ETML-ES-SLO/PRJ_1819_EmetteurDCF/1819A/doc/Présentations/PROJ_DESIGN.pptx

## Emmetteur DCF Partie Design

Julie Culand
Etml-es
Sl02
2018-2019

## Table des matières

- Description du produit (schéma bloc)
- Détail du schéma bloc
=> Choix technologiques
=> Dimensionnement
- Conclusion

## Description du produit voulu

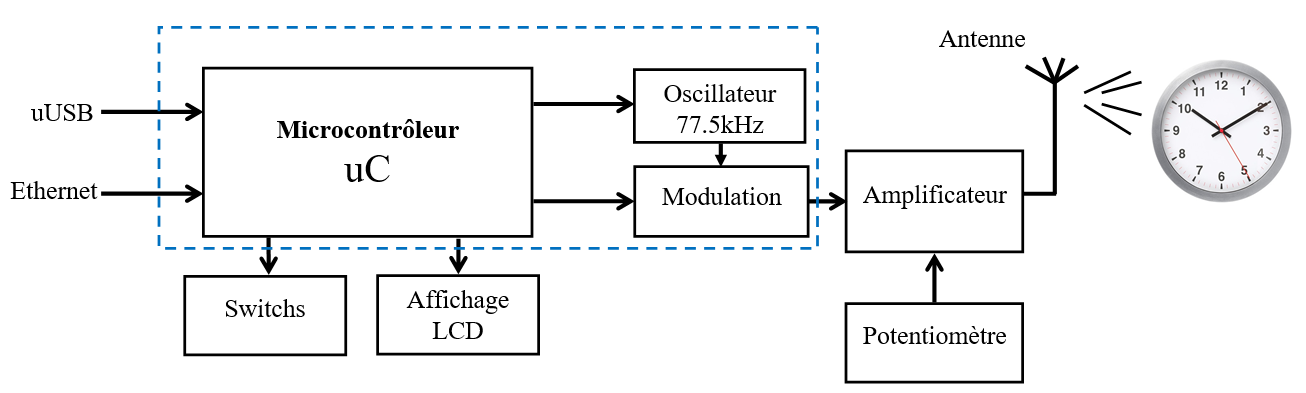
[picture p1: figure]

## Détail du schéma bloc

- Alimentation uUSB
- Touches menu
- Régulateur 5V à 3V3
- Affichage LCD
- Signaux DCF
- RESET du uC & Connecteur de programmation
- Contrôleur Ethernet

## Alimentation uUSB

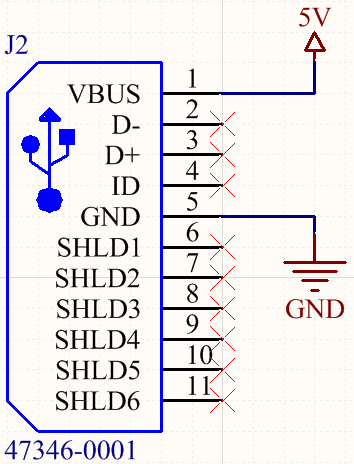
[picture p2: figure]

## Touches menu

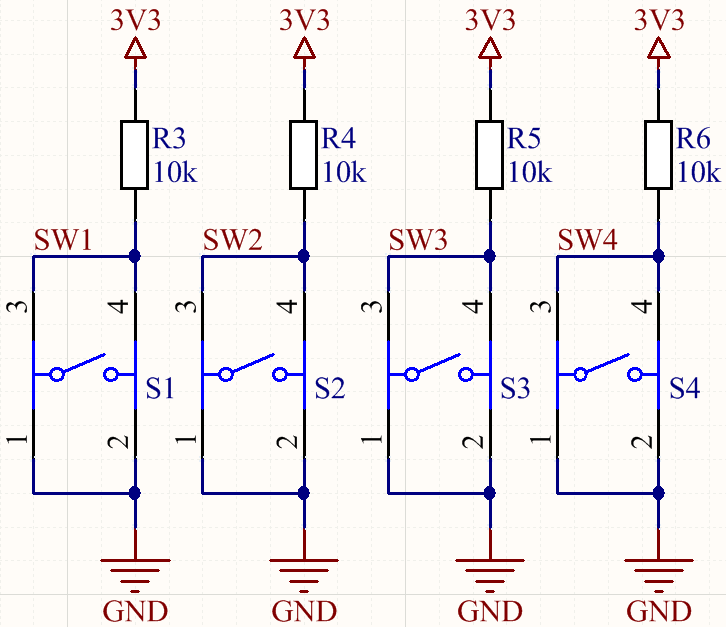
[picture p3: figure]

## Régulateur 5V à 3V3

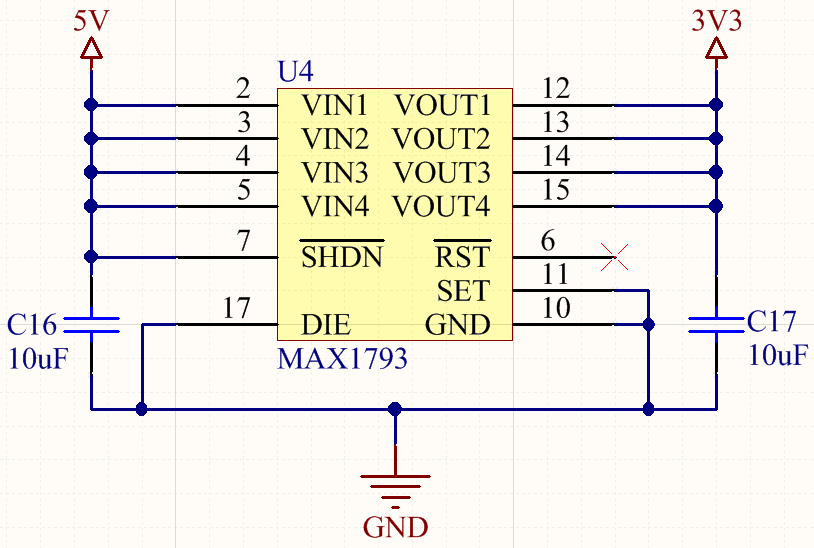
[picture p4: figure]

## Affichage LCD & uC

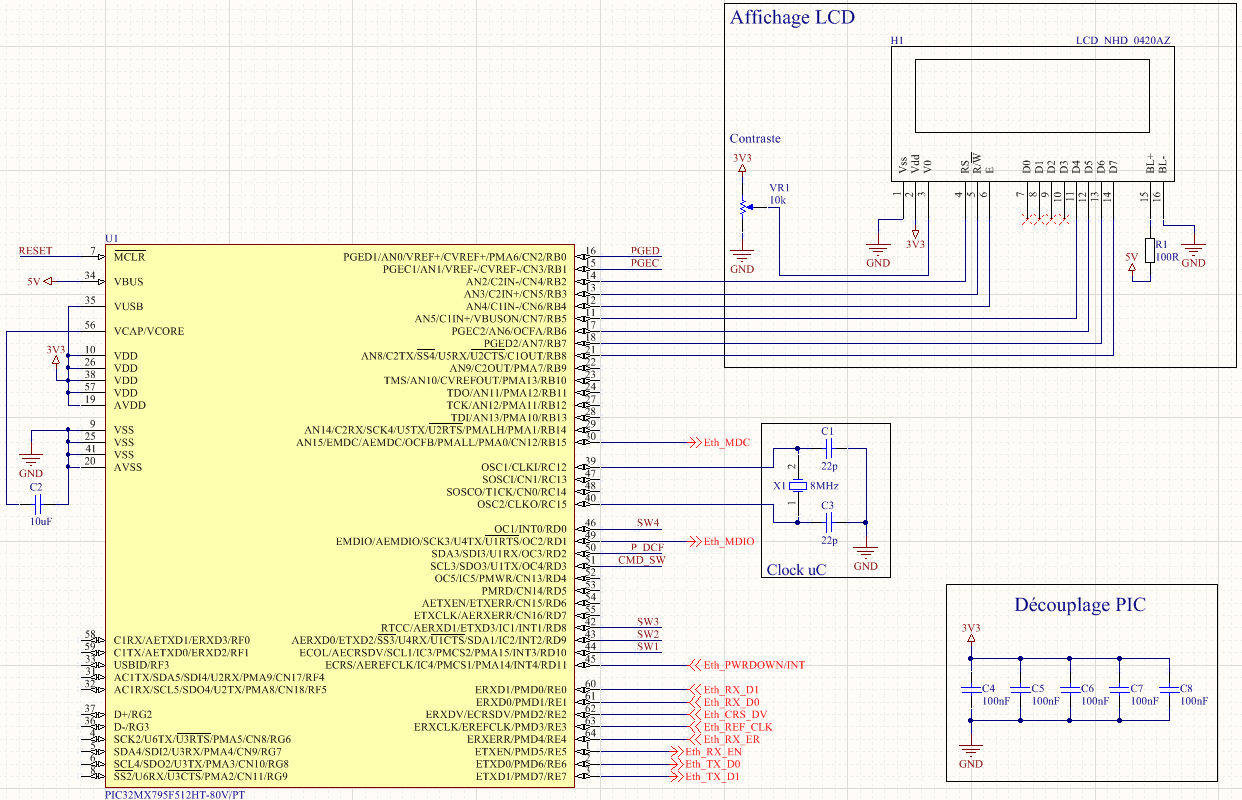
[picture p5: figure]

## Signaux DCF

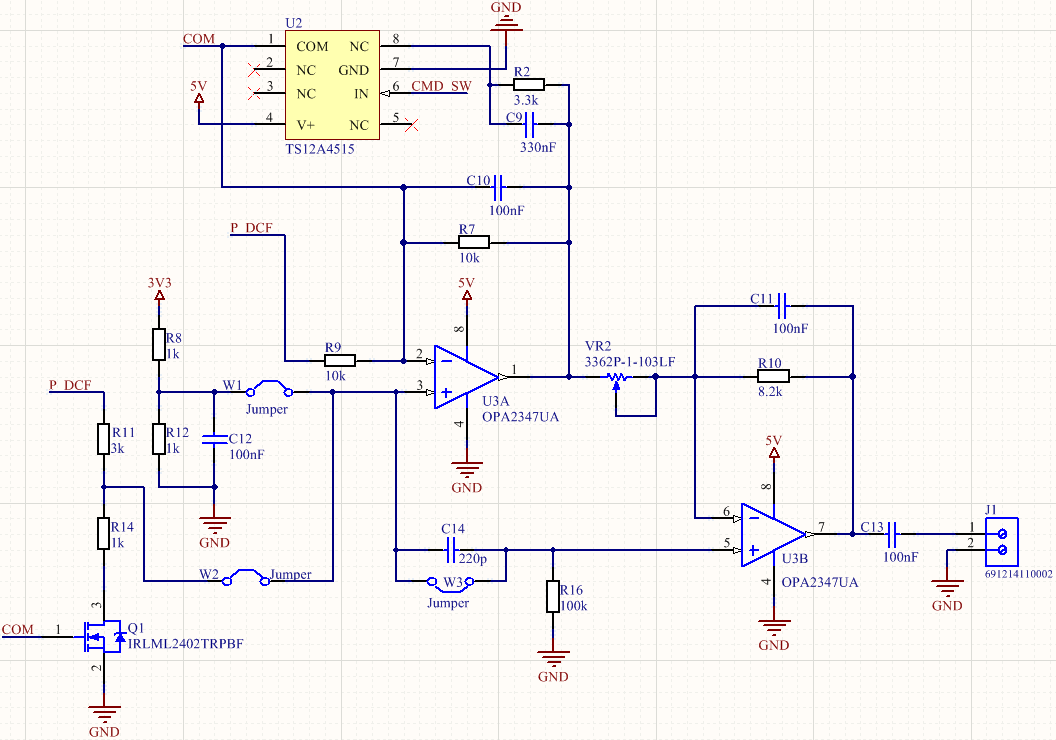
[picture p6: figure]

## Simulation

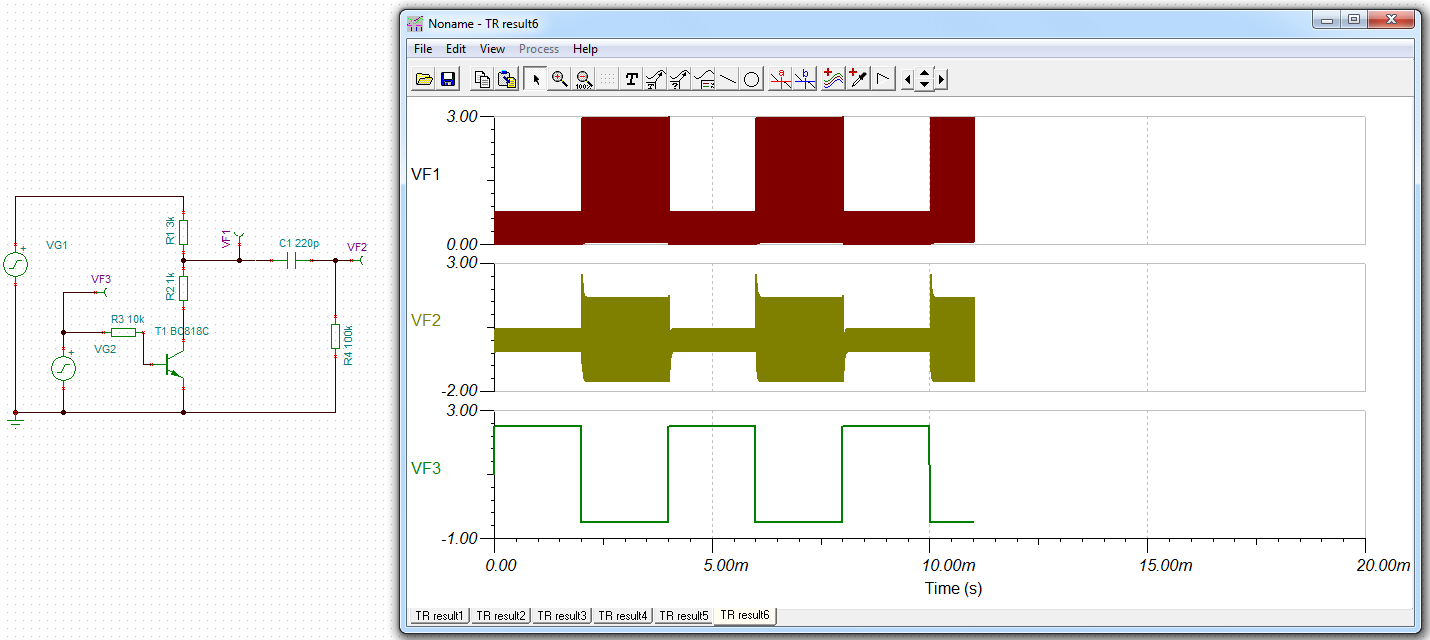
[picture p7: figure]

## RESET du uC & Connecteur de programmation

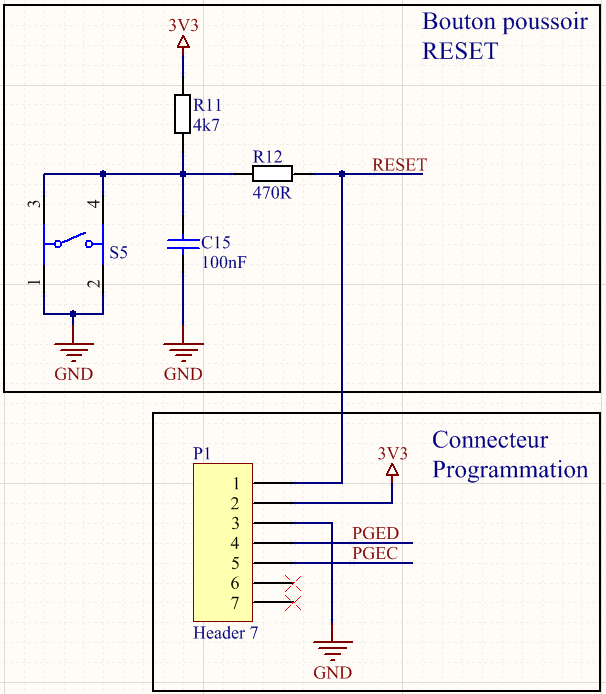
[picture p8: figure]

## Contrôleur Ethernet

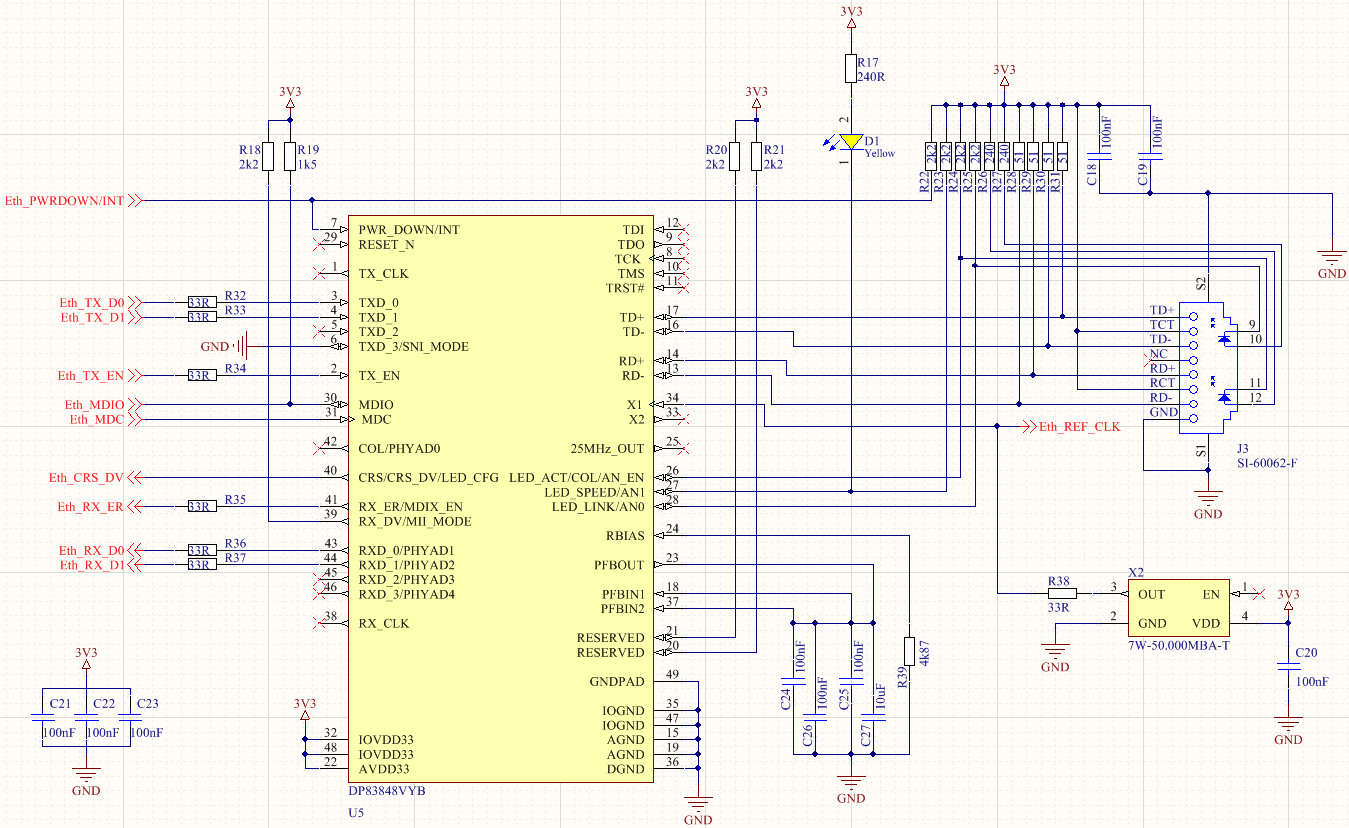
[picture p9: figure]

## Conclusion

- Réalisation Schéma électrique
- Choix technologies + taille de boîtiers
- Travailler dans un esprit "d'entreprise"
- Partie DCF
- Réalisation du PCB

## QUESTIONS ?

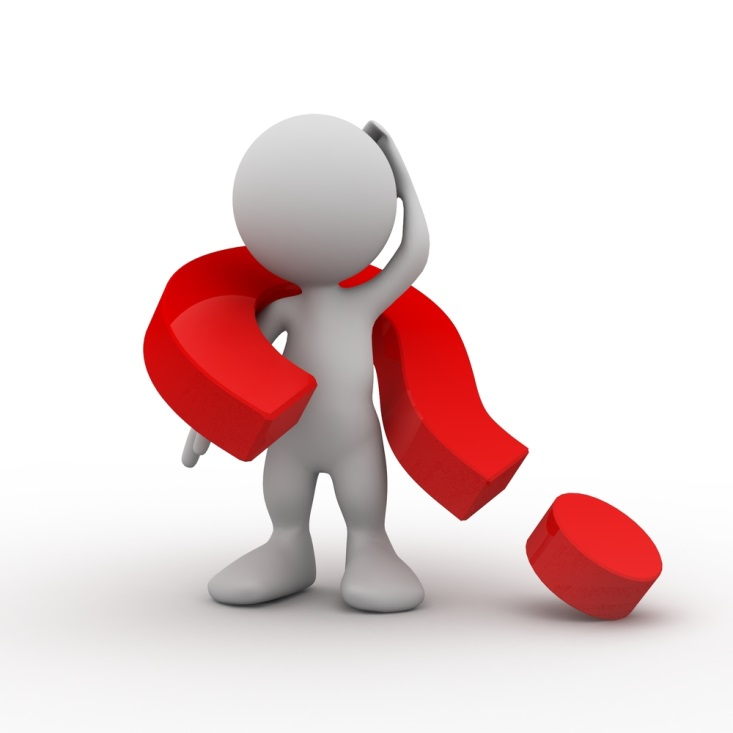
[picture p10: figure]
