ETML-ES-SLO/PRJ_1819_EmetteurDCF/1819A/doc/ANNEXES/Annexe_VIII_Normes_Euro_circuit.pdf

Normes Euro-circuit

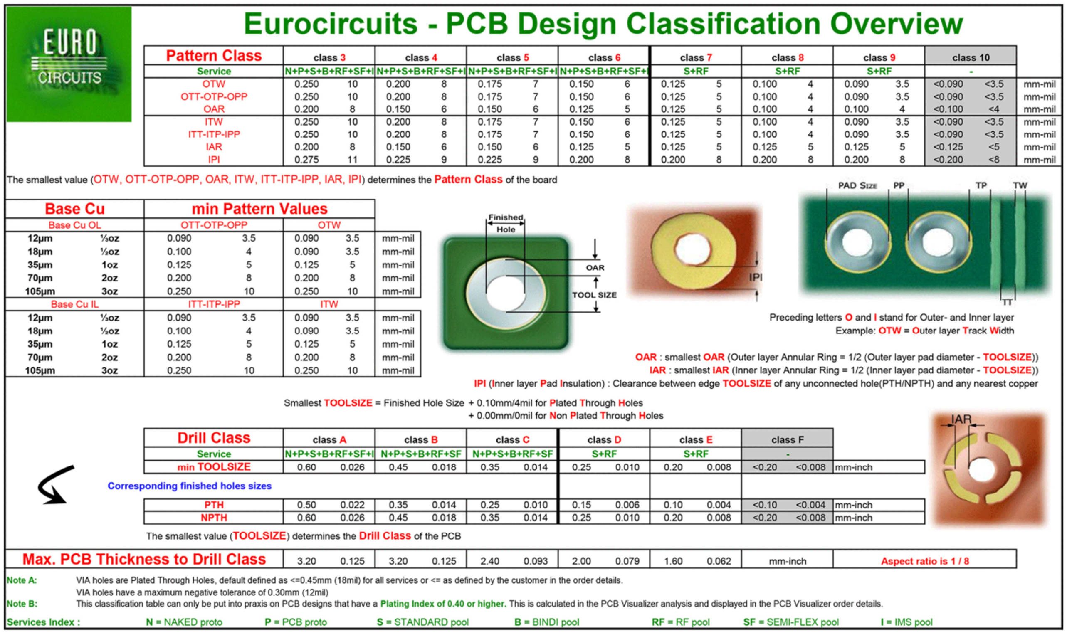
[picture p11: figure]

Normes : 6C
