ETML-ES-SLO/PRJ_1819_EmetteurDCF/1819A/doc/Doc DCF/Homebrew DCF-77 Transmitter.pdf

Homebrew DCF-77 Transmitter | https://www.changpuak.ch/electronics/DCF77.php

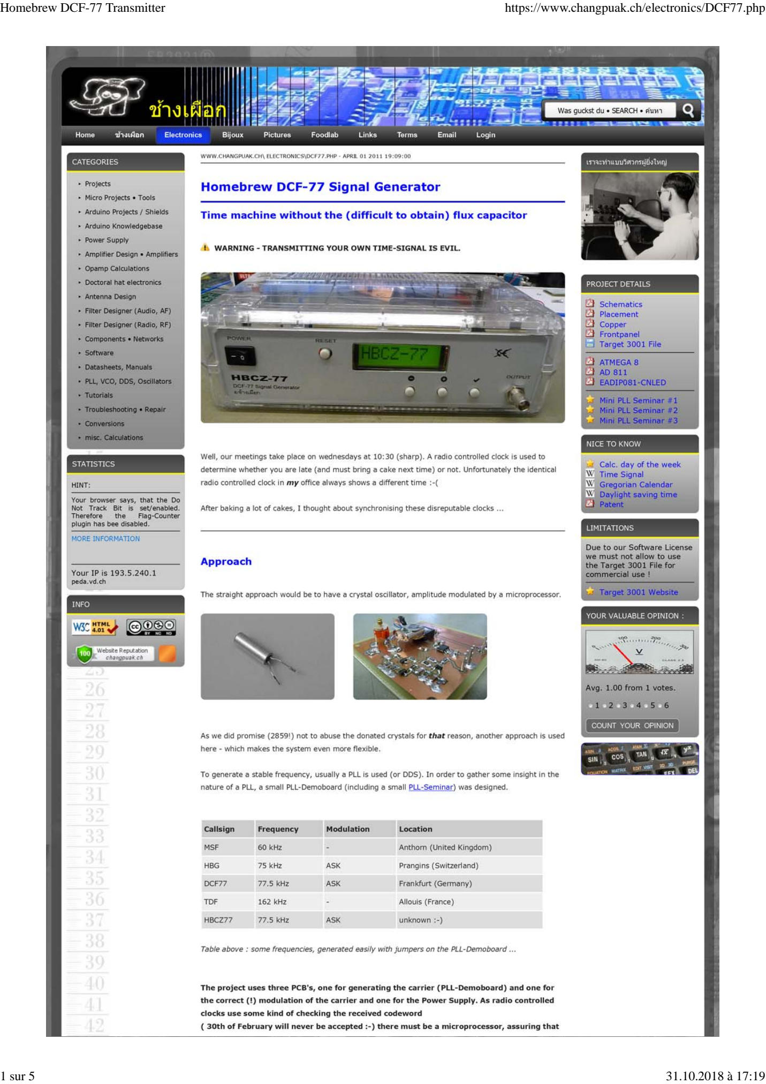
[picture p18: page 1]

1 sur 5 | 31.10.2018 à 17:19

the sent generated codeword is valid.

- PCB#1 may be any clock source of the carrier of your choice. We use the PLL-Demoboard.
- PCB#2 is the Frontpanel, containing the Microprocessor and ASK Modulator. (Picture below)
- PCB#3 is some kind of Power Supply, delivering +12V...+30V/200 mA and + 5V/100 mA.

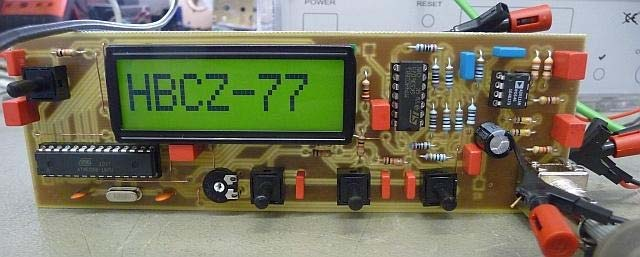
[picture p19: figure]

Picture above : The Mainboard, assembled, behind the Frontpanel.

## Modulation

The Amplitude Modulation is done with 4 AND-Gates and a R-2R Network. It is therefore possible to modulate the TTL Signal with 16 Steps.

This is somehow cracking a nut with a sledgehammer, but we wanted to present something nifty to comply with the 'educational aspect'.

Note: As we wanted to have a single sided PCB, we reduced this later to 3 Bit.

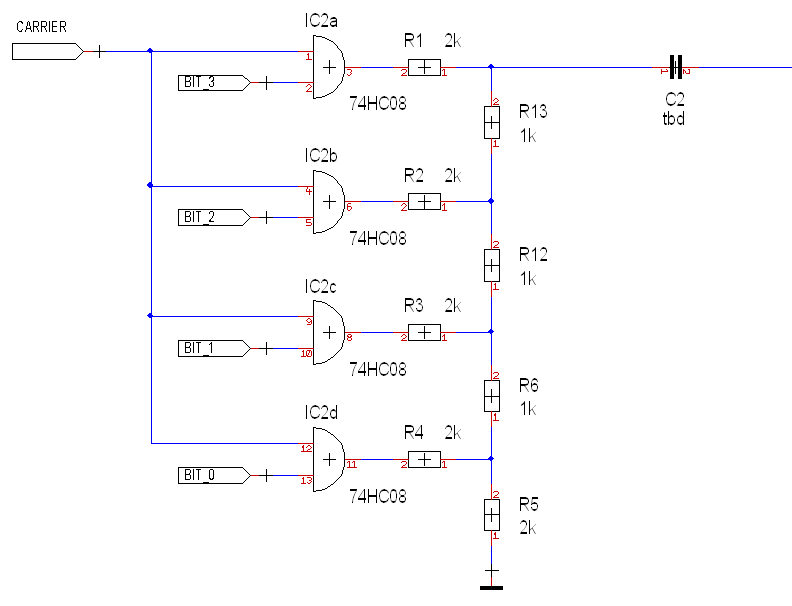
[picture p20: figure]

## ... and what you see on a Scope

Where a '0' is represented by a 100 ms drop to 25% Amplitude and a '1' drop lasts 200 ms.

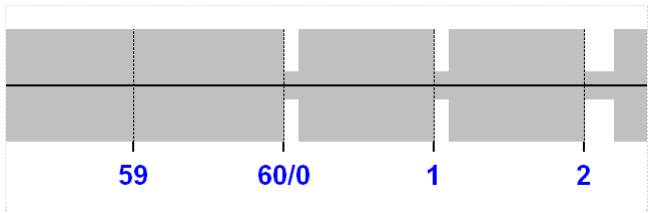
[picture p21: figure]

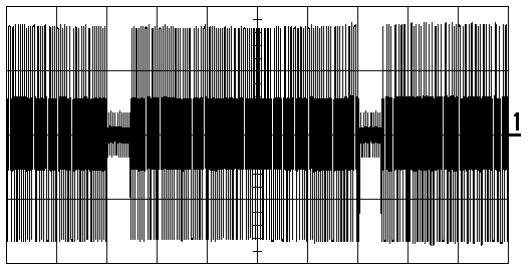
[picture p22: figure]

Picture above : Horizontal: 200 ms/DIV, Vertical: 1 V/DIV

## DCF77 Time Code (similiar to HBCZ77 Time Code :-)

Bit/Sec. | Meaning | Remarks
0 | Start of a Minute | always = 0
1-14 | reserved / for future use
15 | 0=Normal Antenna, 1=Backup Antenna
16 | Summer Time Announcement | Set 1 hour before
17 | Summer Time 0=No, 1=Yes
18 | Winter Time 0=No, 1=Yes
19 | Leap Second announcement | Set 1 hour before
20 | Startbit encoded Time | always = 1
21 | Minutes, weight = 1
22 | Minutes, weight = 2
23 | Minutes, weight = 4
24 | Minutes, weight = 8
25 | Minutes, weight = 10
26 | Minutes, weight = 20
27 | Minutes, weight = 40
28 | Parity Bit Minutes (even) | Bits 21 - 28
29 | Hours, weight = 1
30 | Hours, weight = 2
31 | Hours, weight = 4
32 | Hours, weight = 8
33 | Hours, weight = 10
34 | Hours, weight = 20
35 | Parity Bit Hours (even) | Bits 29 - 34
36 | Day of the Month, weight = 1
37 | Day of the Month, weight = 2
38 | Day of the Month, weight = 4
39 | Day of the Month, weight = 8
40 | Day of the Month, weight = 10
41 | Day of the Month, weight = 20
42 | Day of the Week, weight = 1 | Monday = 1
43 | Day of the Week, weight = 2 | Tuesday = 2
44 | Day of the Week, weight = 4 | Wednesday = 3
45 | Number of the Month, weight = 1
46 | Number of the Month, weight = 2
47 | Number of the Month, weight = 4
48 | Number of the Month, weight = 8
49 | Number of the Month, weight = 10

50 | Year, weight = 1 | ( 00 - 99 )
51 | Year, weight = 2
52 | Year, weight = 4
53 | Year, weight = 8
54 | Year, weight = 10
55 | Year, weight = 20
56 | Year, weight = 40
57 | Year, weight = 80
58 | Parity Bit Date (even) | Bits 36 - 57
59 | Minute Sync | Carrier unmodulated

Putting it all together ...

A radio controlled clock is modified therefore, that the generated Signal is fed directly into the Amplifier following the Antenna. (Decoupling with an 1 kΩ Resistor).

It is assumed, that the portion radiated through the Antenna is very small, as we use an
Attenuator of 30 dB. (and of course operate it in a fully shielded room :-)

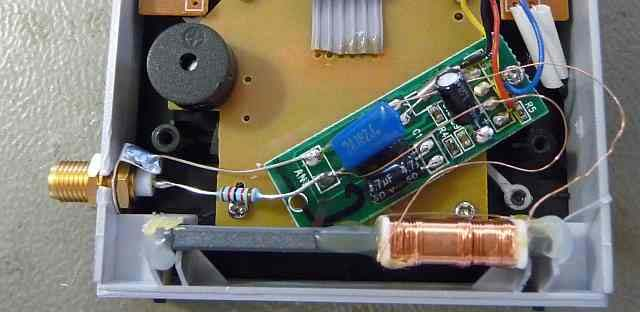
[picture p23: figure]

Connecting the Signal Generator to the Clock - using a DC-Block and a 30 dB Attenuator from Mini Circuits - the Situation is as follows :

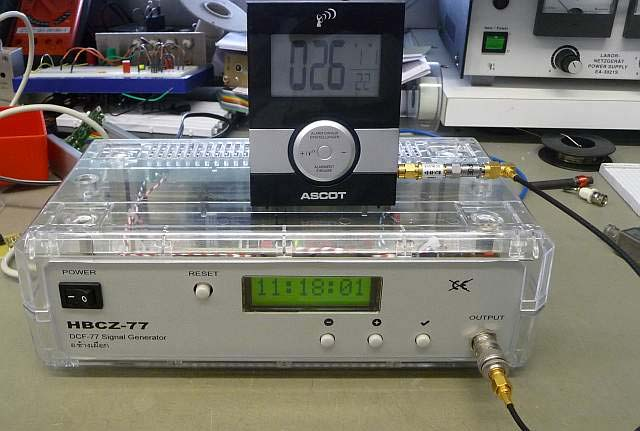
[picture p24: figure]

## ✈ Share your thoughts

✈ Nothing more to be seen below this point ? Maybe your browser blocks the facebook iframe.
✈ The webmaster does not read the comments regularly. Urgent questions should be send via email.

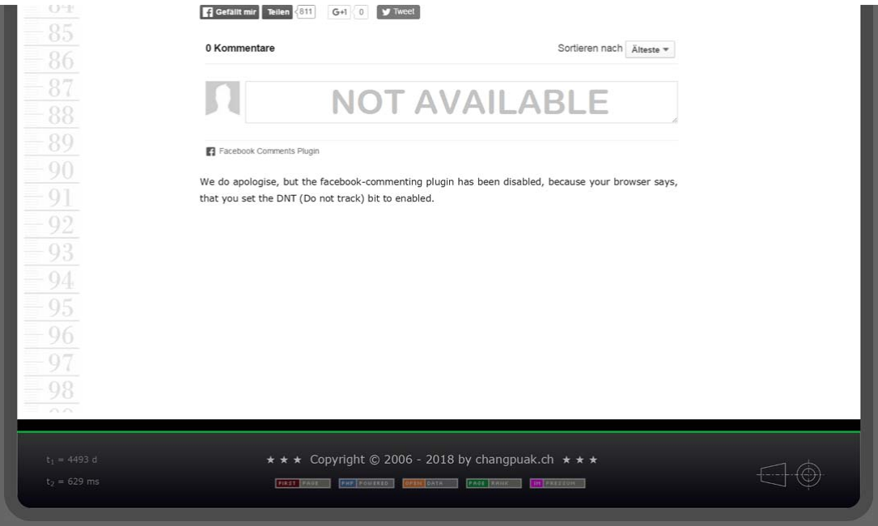
[picture p25: figure]
