ETML-ES-SLO/PRJ_1819_EmetteurDCF/1819A/doc/ANNEXES/Annexe_IV_PLANNING.pdf

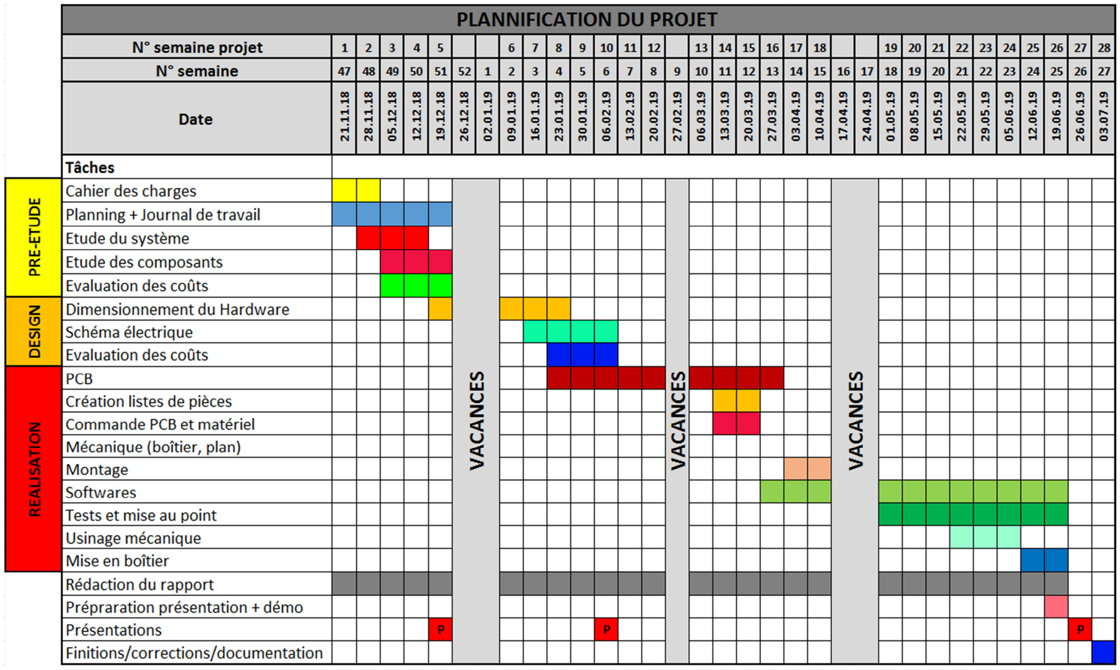
[picture p28: page 1]
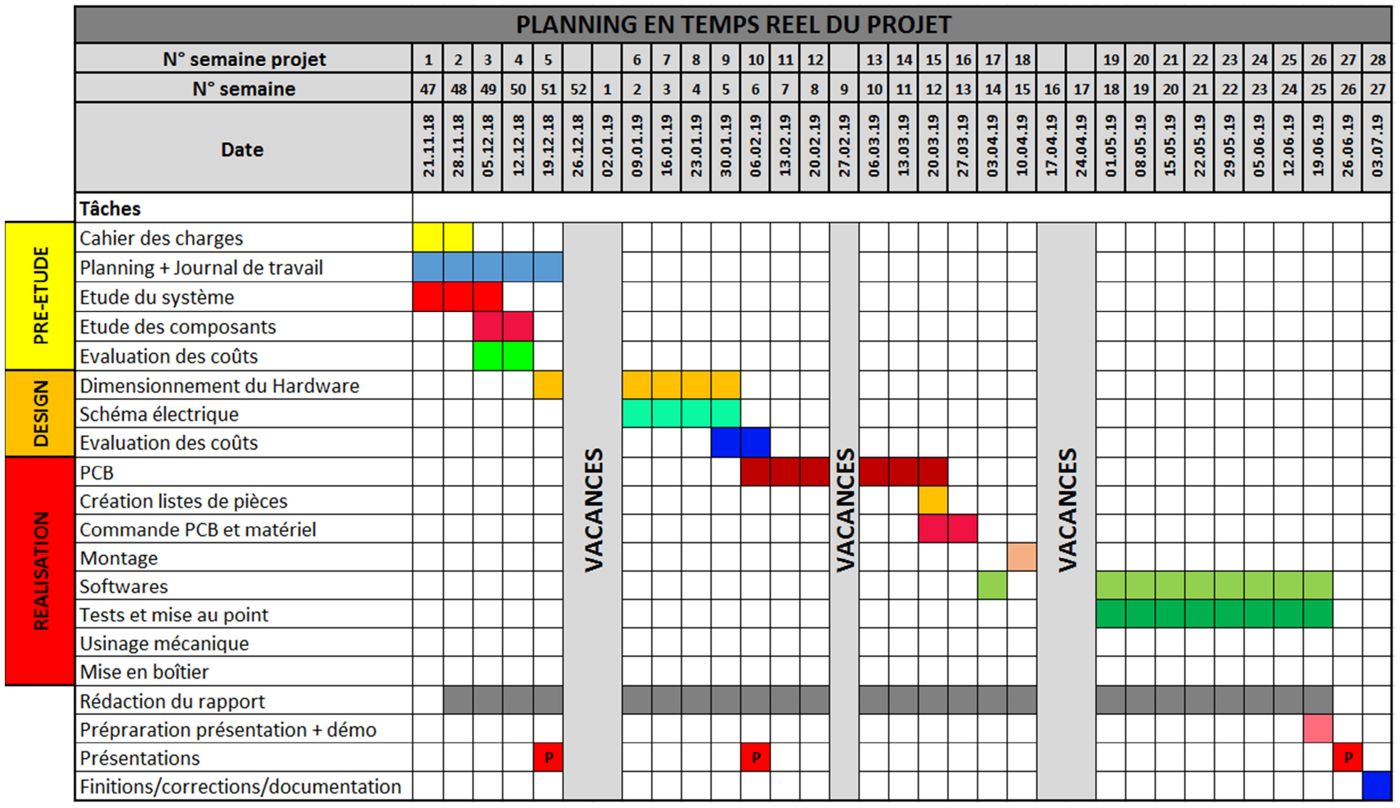
[picture p29: page 2]
