ETML-ES-SLO/PRJ_1819_EmetteurDCF/1819A/doc/IMAGES/Clock_Diagram.png

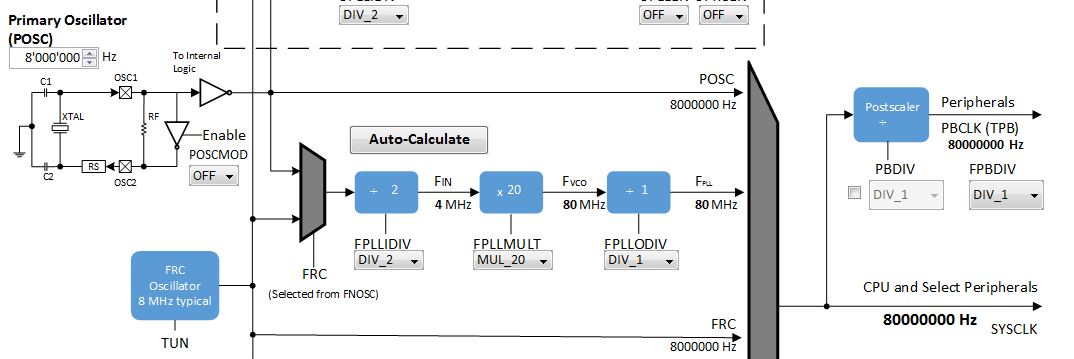
1819A/doc/IMAGES/Clock_Diagram.png
