ETML-ES-SLO/PRJ_1819_EmetteurDCF/1819A/doc/IMAGES/PIN_DIAGRAM.png

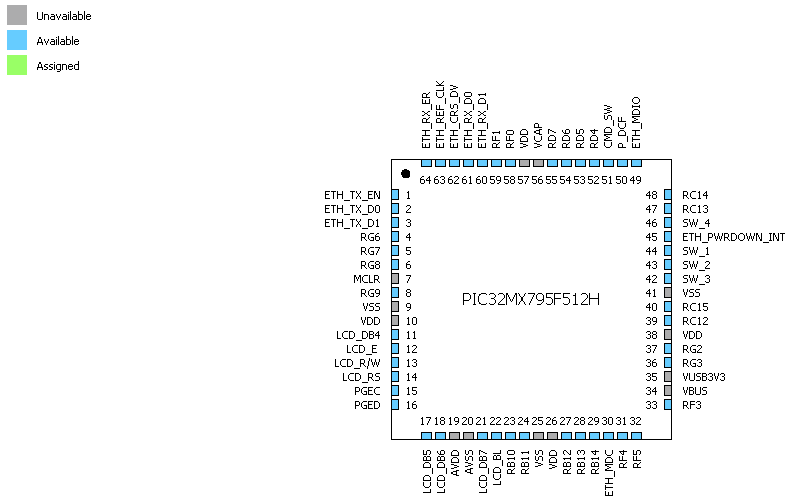
1819A/doc/IMAGES/PIN_DIAGRAM.png
