ETML-ES-SLO/PRJ_1819_EmetteurDCF/1819A/doc/IMAGES/Pin_Settings_1.png

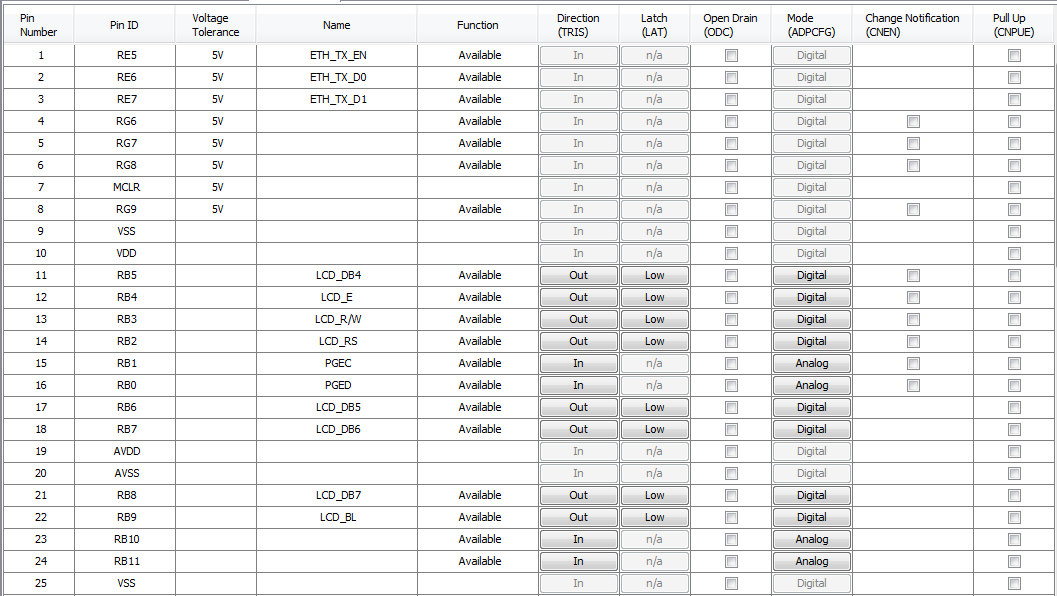
1819A/doc/IMAGES/Pin_Settings_1.png
