ETML-ES-SLO/PRJ_1819_EmetteurDCF/1819A/doc/Plan_Montage.xlsx

PLAN DE MONTAGE
Quantity | Comment | Description | Boîtier | Designator | SMD / THT | Ordre montage
19 | 100nF | Capacitor | 0805 | C1, C2, C3, C4, C5, C9, C11, C12, C13, C14, C18, C19, C20, C21, C22, C23, C24, C25, C26 |  | 3
2 | 22pF | Capacitor | 0805 | C6, C8 |  | 3 | SMD
4 | 10uF | Capacitor | 0805 | C7, C16, C17, C27 |  | 3 | THT
1 | 330nF | Capacitor | 0805 | C10 |  | 3
1 | 220pF | Capacitor | 0805 | C15 |  | 3
1 | Yellow | SMT Chip LED | 0805 | D1 |  | 5
1 | LCD_NHD_0420AZ | Affichage LCD | ------------- | H1 |  | 23
1 | 691214110002S | Bornier 2 pôles | ------------- | J1 |  | 21
1 | 47346-0001 | Micro-USB B | ------------- | J2 |  | 13
1 | SI-60062-F | RJ45 Connector | ------------- | J3 |  | 22
1 | Header 7 | Header, 7-Pin | ------------- | P1 |  | 20
2 | BC857B | PNP Transistor | SOT23 | Q1, Q2 |  | 6
2 | IRLML2402TRPBF | MOSFET, N-Channel | SOT23-3 | Q3, Q4 |  | 7
1 | 39R | Resistor | 0805 | R1 |  | 4
7 | 10k | Resistor | 0805 | R2, R3, R4, R5, R12, R14, R16 |  | 4
1 | 1k8 | Resistor | 0805 | R6 |  | 4
1 | 200R | Resistor | 0805 | R7 |  | 4
2 | 100k | Resistor | 0805 | R8, R20 |  | 4
1 | 4k7 | Resistor | 0805 | R9 |  | 4
1 | 470R | Resistor | 0805 | R10 |  | 4
1 | 3.3k | Resistor | 0805 | R11 |  | 4
3 | 1k | Resistor | 0805 | R13, R18, R19 |  | 4
1 | 13k | Resistor | 0805 | R15 |  | 4
1 | 3k | Resistor | 0805 | R17 |  | 4
1 | 240R | Resistor | 0805 | R21 |  | 4
7 | 2k2 | Resistor | 0805 | R22, R24, R25, R26, R27, R28, R29 |  | 4
1 | 1k5 | Resistor | 0805 | R23 |  | 4
2 | 240 | Resistor | 0805 | R30, R31 |  | 4
4 | 51 | Resistor | 0805 | R32, R33, R34, R35 |  | 4
7 | 33R | Resistor | 0805 | R36, R37, R38, R39, R40, R41, R42 |  | 4
1 | 4k87 | Resistor | 0805 | R43 |  | 4
4 | 430152095836 | SMD Tact Switch | ------- | S1, S2, S3, S4 |  | 14
1 | 430152043836 | SMD Tact Switch | ------- | S5 |  | 15
9 | 5019 | Test Point SMD | ------- | TP1, TP2, TP3, TP4, TP5, TP6, TP7, TP8, TP9 |  | 16
1 | PIC32MX795F512HT | 32-Bit Microcontroller |  | U1 |  | 1
1 | TS12A4515D | CMOS Analog Switch |  | U2 |  | 8
1 | OPA2347UA | Operational Amplifier | SOIC8 | U3 |  | 9
1 | MAX1793 | Régulateur 3V3 | TSSOP-16 | U4 |  | 10
1 | DP83848VYB | CI Ethernet |  | U5 |  | 2
2 | 3362P-1-103LF | Potentiometer, 10 K | ------- | VR1, VR2 |  | 17
2 | Jumper_2pos | Jumper Wire | ------- | W1, W3 |  | 18
1 | Jumper_3pos | Jumper Wire | ------- | W2 |  | 19
1 | ECS-80-18-5PX-TR | Quartz 8.0 MHz | HC-49/US | X1 |  | 12
1 | 7W-50.000MBA-T | OSC, 50.000 MHZ | 4-SMD | X2 |  | 11
