ETML-ES-SLO/PRJ_1819_EmetteurDCF/1819A/doc/Liste_Pieces_1819_Emmeteur_DCF.xlsx

Quantity | Comment | Description | Boîtier | Designator | Fabriquant | Fournisseur | n°commande | Prix/pièce | Prix total | Stock | Commandé | Reçu
19 | 100nF | Capacitor | 0805 | C1, C2, C3, C4, C5, C9, C11, C12, C13, C14, C18, C19, C20, C21, C22, C23, C24, C25, C26 | ------------- | ------------- | ------------- | ------------- | ------------- |  | OK | OK
2 | 22pF | Capacitor | 0805 | C6, C8 | ------------- | ------------- | ------------- | ------------- | ------------- |  | OK | OK
4 | 10uF | Capacitor | 0805 | C7, C16, C17, C27 | ------------- | ------------- | ------------- | ------------- | ------------- |  | OK | OK
1 | 330nF | Capacitor | 0805 | C10 | Samsung Electro-Mechanics | Digi-Key | 1276-1123-1-ND | 0.19.- | 0.19.- |  | OK | OK | stock wurth
1 | 220pF | Capacitor | 0805 | C15 | Samsung Electro-Mechanics | Digi-Key | 1276-2474-1-ND | 0.10.- | 0.10.- |  | OK | OK | stock wurth
1 | Yellow | SMT Mono-color Chip LED | 0805 | D1 | ------------- | ------------- | ------------- | ------------- | ------------- |  | OK | OK
1 | LCD_NHD_0420AZ | Affichage LCD | ------------- | H1 | Newhaven Display Intl | Digi-Key | NHD-0420AZ-FSW-GBW-33V3-ND | 19.10.- | 19.10.- |  | OK | OK | 2019-04-03
1 | 691214110002S | Bornier 2 pôles | ------------- | J1 | Würth Elektronik | MOUSER | 710-691214110002S | 1.11.- | 1.11.- |  | OK | OK | 2019-04-03
1 | 47346-0001 | Micro-USB B Receptacle with Flange, -30 to 85 degC, 5-Pin SMD, RoHS, Tape and Reel | ------------- | J2 | Molex | MOUSER | 538-47346-0001 | 0.89.- | 0.89.- |  | OK | OK | 2019-04-03
1 | SI-60062-F | 1 Port RJ45 Magjack Connector with Yellow and Green LED, 10/100 Base-T, 12-Pin THD, RoHS, Tray | ------------- | J3 | Stewart Connector | Digi-Key | 380-1106-ND | 4.58.- | 4.58.- |  | OK | OK
1 | Header 7 | Header, 7-Pin | ------------- | P1 | ------------- | ETML-ES | ------------- | ------------- | ------------- |  | OK | OK
2 | BC857B | PNP Silicon AF Transistor | SOT23 | Q1, Q2 | ------------- | ETML-ES | ------------- | ------------- | ------------- |  | OK | OK
2 | IRLML2402TRPBF | Power MOSFET, N-Channel | SOT23-3 | Q3, Q4 | Infineon Technologies | Digi-Key | IRLML2402PBFCT-ND | 0.43.- | 0.86.- |  | OK | OK
1 | 39R | Resistor | 0805 | R1 | ------------- | ETML-ES | ------------- | ------------- | ------------- |  | OK | OK
7 | 10k | Resistor | 0805 | R2, R3, R4, R5, R12, R14, R16 | ------------- | ETML-ES | ------------- | ------------- | ------------- |  | OK | OK
1 | 1k8 | Resistor | 0805 | R6 |  |  |  | ------------- | ------------- |  | OK | OK
1 | 200R | Resistor | 0805 | R7 | ------------- | ETML-ES | ------------- | ------------- | ------------- |  | OK | OK
2 | 100k | Resistor | 0805 | R8, R20 | ------------- | ETML-ES | ------------- | ------------- | ------------- |  | OK | OK
1 | 4k7 | Resistor | 0805 | R9 | ------------- | ETML-ES | ------------- | ------------- | ------------- |  | OK | OK
1 | 470R | Resistor | 0805 | R10 | ------------- | ETML-ES | ------------- | ------------- | ------------- |  | OK | OK
1 | 3.3k | Resistor | 0805 | R11 | ------------- | ETML-ES | ------------- | ------------- | ------------- |  | OK | OK
3 | 1k | Resistor | 0805 | R13, R18, R19 | ------------- | ETML-ES | ------------- | ------------- | ------------- |  | OK | OK
1 | 13k | Resistor | 0805 | R15 | ------------- | ETML-ES | ------------- | ------------- | ------------- |  | OK | OK
1 | 3k | Resistor | 0805 | R17 | ------------- | ETML-ES | ------------- | ------------- | ------------- |  | OK | OK
1 | 240R | Resistor | 0805 | R21 | ------------- | ETML-ES | ------------- | ------------- | ------------- |  | OK | OK
7 | 2k2 | Resistor | 0805 | R22, R24, R25, R26, R27, R28, R29 | ------------- | ETML-ES | ------------- | ------------- | ------------- |  | OK | OK
1 | 1k5 | Resistor | 0805 | R23 | ------------- | ETML-ES | ------------- | ------------- | ------------- |  | OK | OK
2 | 240 | Resistor | 0805 | R30, R31 | ------------- | ETML-ES | ------------- | ------------- | ------------- |  | OK | OK
4 | 51 | Resistor | 0805 | R32, R33, R34, R35 | ------------- | ETML-ES | ------------- | ------------- | ------------- |  | OK | OK
7 | 33R | Resistor | 0805 | R36, R37, R38, R39, R40, R41, R42 | ------------- | ETML-ES | ------------- | ------------- | ------------- |  | OK | OK
1 | 4k87 | Resistor | 0805 | R43 | Stackpole electronic Inc | Digi-Key | RNCP0805FTD4K87CT-ND | 0.10.- | 0.10.- |  | OK | OK | 2019-04-03
4 | 430152095836 | SMD Tact Switch WS-TASV | ------------- | S1, S2, S3, S4 | Würth Elektronik | Würth Elektronik | 430152095836 | ------------- | ------------- |  | OK | OK
1 | 430152043836 | SMD Tact Switch WS-TASV | ------------- | S5 | Würth Elektronik | Würth Elektronik | 430152043836 | ------------- | ------------- |  | OK | OK
9 | 5019 | Test Point SMD | ------------- | TP1, TP2, TP3, TP4, TP5, TP6, TP7, TP8, TP9 | Keystone Electronics | Digi-Key | 36-5019CT_ND | 0.35.- | 3.15.- |  | OK | OK | 2019-04-03
1 | PIC32MX795F512HT | 32-Bit Flash Microcontroller |  | U1 | Microchip Technology | MOUSER | 579-PIC32MX795F512T | 8.97.- | 8.97.- |  | OK | OK | 2019-04-03
1 | TS12A4515D | Resistance SPST CMOS Analog Switch |  | U2 | Texas Instruments | Digi-Key | 296-21909-1-ND | 0.78.- | 0.78.- |  | OK | OK | 2019-04-03
1 | OPA2347UA | MicroPower, Rail-to-Rail Operational Amplifier | SOIC8 | U3 | Texas Instruments | Digi-Key | OPA2347UA-ND | 1.37.- | 1.37.- |  | OK | OK | 2019-04-03
1 | MAX1793 | Régulateur 3V3 | TSSOP-16 | U4 | Maxim Integrated | MOUSER | 700-MAX1793EUE33T |  |  |  | OK | OK
1 | DP83848VYB | CI Ethernet |  | U5 | Texas Instruments | Digi-Key | DP83848VYB/NOPB-ND | 24.12.- | 24.12.- |  | OK | OK
2 | 3362P-1-103LF | Trimpot(R) Trimming Potentiometer, 10 KOhm | ------------- | VR1, VR2 | Bourns | MOUSER | 652-3362P-1-103LF | 1.02.- | 2.04.- |  | OK | OK
2 | Jumper_2pos | Jumper Wire | ------------- | W1, W3 | ------------- | ------------- | ------------- | ------------- | ------------- |  | OK | OK
1 | Jumper_3pos | Jumper Wire | ------------- | W2 | ------------- | ------------- | ------------- | ------------- | ------------- |  | OK | OK
1 | ECS-80-18-5PX-TR | Quartz Crystal, 8.0 MHz, 2-Pin SMD | HC-49/US | X1 | ECS | MOUSER | 520-CSM800-18-X | 0.46.- | 0.46.- |  | OK | OK
1 | 7W-50.000MBA-T | OSC, 50.000 MHZ, ± 25 ppm, 3.3 V, SMT | 4-SMD | X2 | TXC CORPORATION | Digi-Key | 887-1379-1-ND | 2.27.- | 2.27.- |  | OK | OK | 2019-04-03
1 | Boîtier plastique | 60x120x120 | ------------- | ------------- | HAMMOND | Digi-Key | HM3475-ND | 22.83.- | 22.83.- |  | OK | OK | 2019-04-03
 | En Stock |  |  | Commandé
 | Pas en stock |  |  | Reçu
 |  |  |  | En attente
