ETML-ES-SLO/PRJ_1819_EmetteurDCF/1819A/doc/Doc DCF/DCFake77_ How to radio-control your clock by yourself - raspibo.pdf

Da raspibo.

This project is composed by a DCF77 receiver (based on arduino) and a DCF77 Transmitter (based on Raspberry PI).

DCF77 (https://en.wikipedia.org/wiki/DCF77) is a radio signal at 77.5Khz. The transmitter is if Frankfurt. It broadcasts the synchronization signal for radio controlled watches and clocks.

Unfortunately it is getting harder and harder to get the signal from Frankfurt, as there are many sources of radio noise (e.g. several weakly designed switching power supplies).

I have built a simlpe receiver using a specific antenna and a Arduino.

I bought my antenna on e-bay (http://www.ebay.it/itm/181815504817?_trksid=p2060353.m2749.l2649&ssPageName=STRK%3AMEBIDX%3AIT)

I connected the 4 pins of tha antenna to a Arduino Nano (clone) as follows:

PON -> +3V3
DATA -> D2
GND -> GND
VCC -> +3V3

and loaded the script DCFSignal (included as an example of the DCF77 library)

?
1
2
3
4
5

/*
* DCFSignal.ino - DCF77 debug Example
* Thijs Elenbaas, 2012
* This example code is in the public domain.
DCFake77: How to radio-control your clock by yourself - raspibo | http://www.raspibo.org/wiki/index.php?title=DCFake77:_How_to_rad...
1 sur 4 | 31.10.2018 à 17:26

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
This simple example shows the raw signal coming from the DCF decoder.

Pulse-to-Pulse is approximately 1000 ms and pulse with is approx 100ms or 200ms The axis underestimates the elapsed time slightly, because a single loop takes a bit longer than 10ms.
*/

#define BLINKPIN 13

#define DCF77PIN 2

int prevSensorValue=0;

void setup() {
Serial.begin(9600);
pinMode(DCF77PIN, INPUT);
pinMode(13, OUTPUT);
Serial.println("0ms | 100ms | 200ms | 300ms | 400ms | 500ms | 600ms | 700ms | 800ms | 900ms | 1000ms
1100ms | 1200ms");
}

void loop() {
int sensorValue = digitalRead(DCF77PIN);
if (sensorValue==1 && prevSensorValue==0) { Serial.println(""); } digitalWrite(BLINKPIN, sensorValue);
Serial.print(sensorValue);
prevSensorValue = sensorValue;
delay(10);
}

Using a terminal emulator

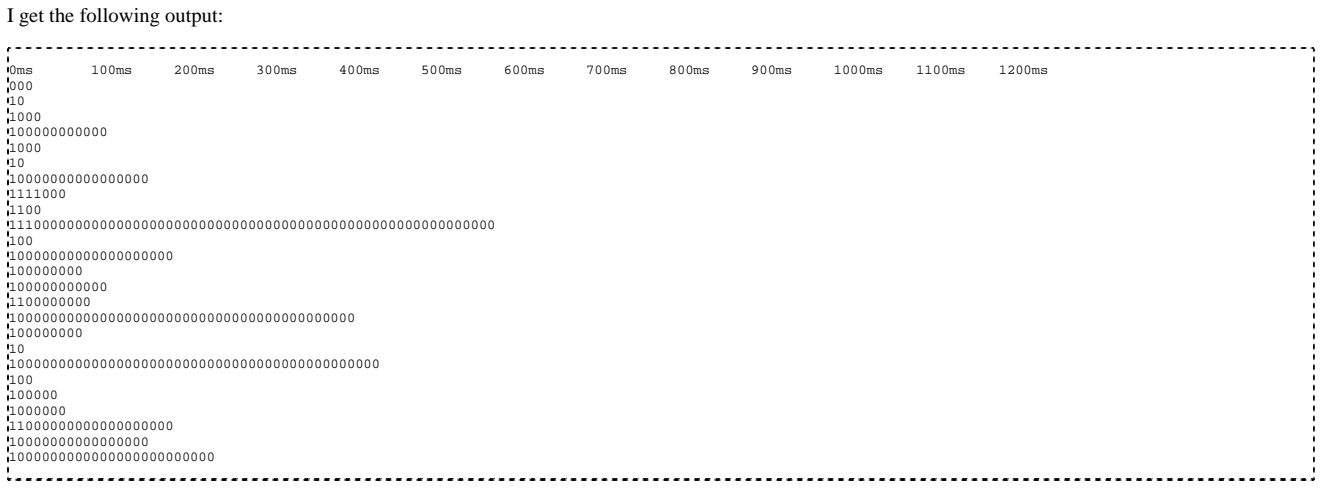
[picture p44: figure]
I get the following output:

.... while a "clean" output should be like this published here (http://thijs.elenbaas.net/2012/04/arduino-dcf77-radio-clock-receiver-signal/) :

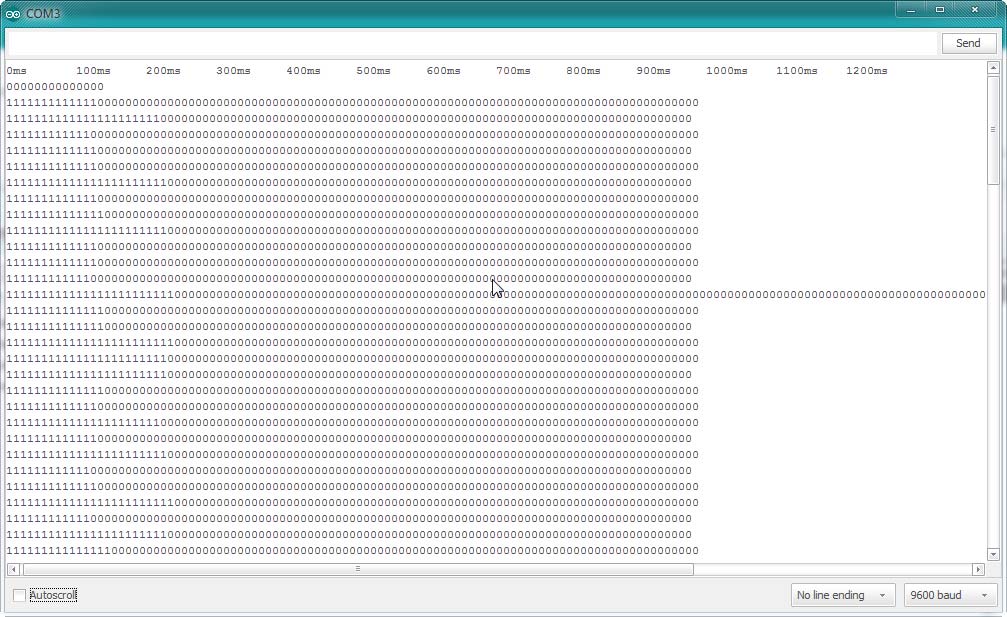
[picture p45: figure]

It means that the signal is very noisy so this is the reason why my radtiocontrolled clocks and watches won't synchronize with DCF-77.

DCFake77

Warning: this is just an experimental project. It may not be allowed to trasmit signals on the DCF frequency. This project should send signals received only some meters away. It would be very easy to design a power amplifier but in this case I am pretty sure you'd break some laws.

The main difficulty is to design and build an antenna for trasmitting the DCF signal. I have got an old ferrite rod (recycled from an old broken AM receiver). I wound on it a lot of turns (250?) of copper wire. I used all wire of the reel I had.

Then I used a signal generator and an oscilloscope (in my case I used my Red-Pitaya for both) and found experimentally which capacitors to put in parallel to get the right resonance frequency.

In my case it was 2nF (two 1nF capacitors in parallel).

So I connected my antenna to a Rasberry 2 as follows:

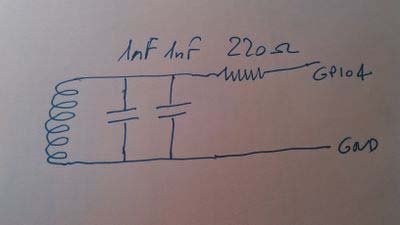
[picture p46: figure]

The resistor protects my raspberry if accidentally it tries to send signals out from the resonating range.

The program running on my Raspberry PI is a bit too long to stay on this page. So it can be downloaded from [1] (http://www.raspibo.org/renzo/dcfake77.c) here. It uses the clock generator on pin4.

The program needs no specific libraries so it can be compiled in this way:

Dcfake77 has no command line arguments (but need access to /dev/mem, so need root access rights).

At the beginning the program waits for the 59th second to start the protocol and then it sends the date and time of the following minute.

Now the output of the DCFsignal program running on arduino is consistent with the real signal of DCF77.

111111111110000000000000000000000000000000000000000000000000000000000000000000000000000000000000000 1111111111100000000000000000000000000000000000000000000000000000000000000000000000000000000000000000 111111111110000000000000000000000000000000000000000000000000000000000000000000000000000000000000000 1111111111110000000000000000000000000000000000000000000000000000000000000000000000000000000000000000 111111111100000000000000000000000000000000000000000000000000000000000000000000000000000000000000000 111111111100000000000000000000000000000000000000000000000000000000000000000000000000000000000000000 1111111111100000000000000000000000000000000000000000000000000000000000000000000000000000000000000000 111111111110000000000000000000000000000000000000000000000000000000000000000000000000000000000000000 1111111111111111111110000000000000000000000000000000000000000000000000000000000000000000000000000000 111111111111111111111000000000000000000000000000000000000000000000000000000000000000000000000000000 111111111110000000000000000000000000000000000000000000000000000000000000000000000000000000000000000 111111111111111111110000000000000000000000000000000000000000000000000000000000000000000000000000000 1111111111110000000000000000000000000000000000000000000000000000000000000000000000000000000000000000 111111111110000000000000000000000000000000000000000000000000000000000000000000000000000000000000000 1111111111100000000000000000000000000000000000000000000000000000000000000000000000000000000000000000 111111111110000000000000000000000000000000000000000000000000000000000000000000000000000000000000000000000000000000000000000000000000000000000000000000000000000 1111111111111111111110000000000000000000000000000000000000000000000000000000000000000000000000000000 1111111111111111111110000000000000000000000000000000000000000000000000000000000000000000000000000000 111111111111111111111000000000000000000000000000000000000000000000000000000000000000000000000000000 1111111111111111111110000000000000000000000000000000000000000000000000000000000000000000000000000000

If you load on the arduino the example named DCFBinaryStream (also delivered with the DCF77 library) you'll see (after three/four minutes) that the date and time has been correctly received:

1 | - binary 1 corresponding to long pulse
0 | - binary 0 corresponding to short pulse
BF - Buffer is full at end of time-sequence. This is good EoB - Buffer is full before at end of time-sequence
EoM - Buffer is not yet full at end of time-sequence

Estratto da "http://www.raspibo.org/wiki/index.php?title=DCFake77:_How_to_radio-control_your_clock_by_yourself&oldid=5637"

Questa pagina è stata modificata per l'ultima volta il 27 giu 2016 alle 11:56.
Questa pagina è stata letta 6 406 volte.
Contenuti soggetti a licenza d'uso Creative Commons Attribution Share Alike.
