ETML-ES-SLO/PRJ_1819_EmetteurDCF/1819A/doc/ANNEXES/Annexe_V_Liste_Pieces.pdf

# ETML

# Liste de Pièces 1819_A

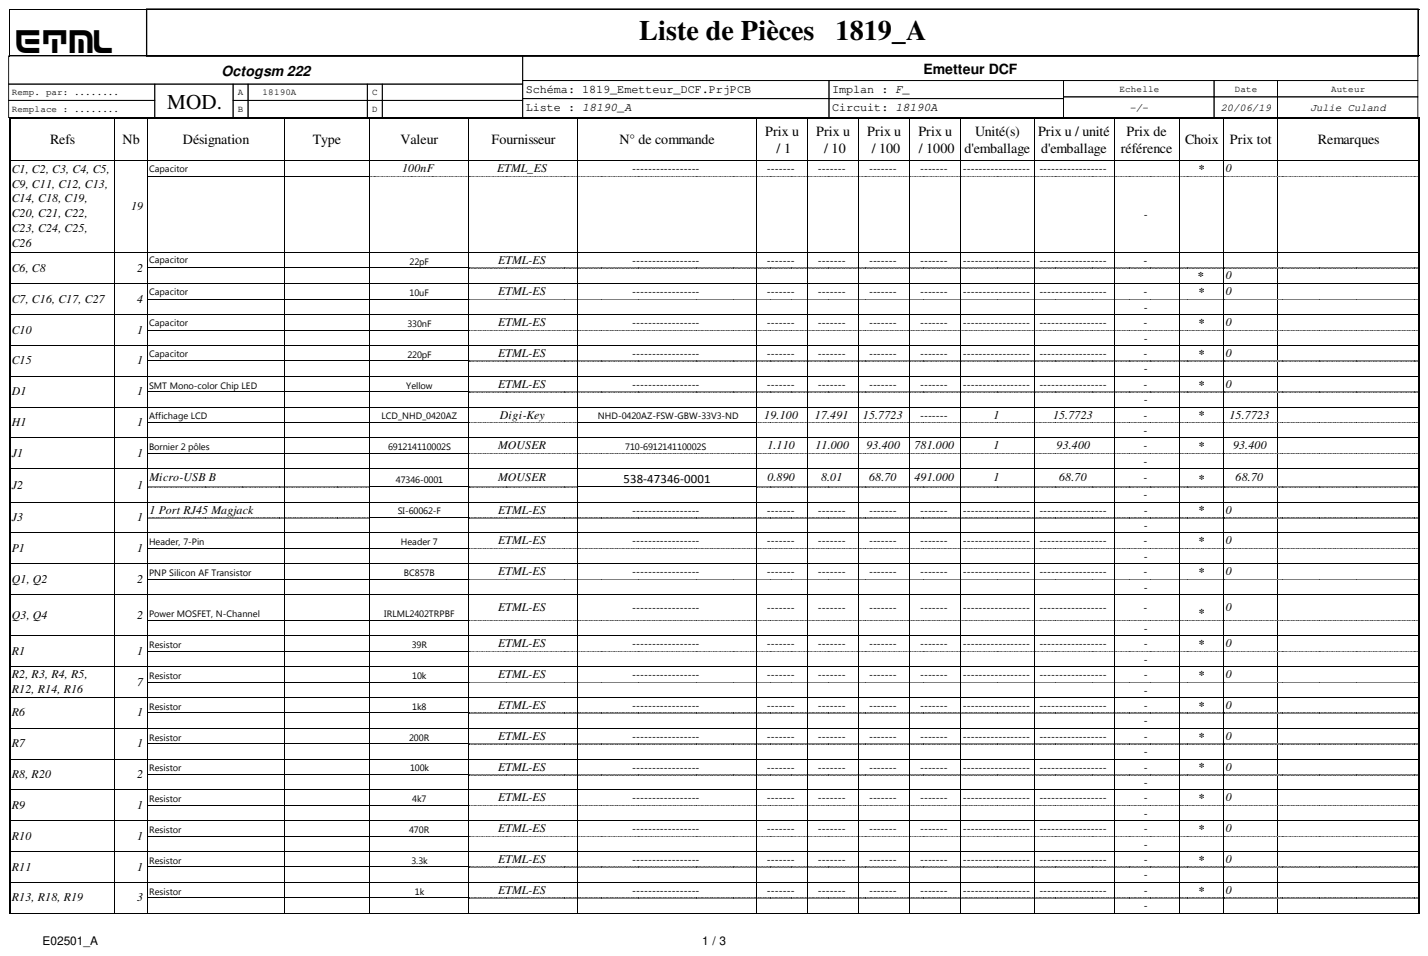
[picture p55: page 1]

Refs | Nb | Désignation | Type | Valeur | Fournisseur | N° de commande | Prix u / 1 | Prix u / 10 | Prix u / 100 | Prix u / 1000 | Unité(s) d'emballage | Prix u / unité d'emballage | Prix de référence | Choix | Prix tot | Remarques

C1, C2, C3, C4, C5, C9, C11, C12, C13, C14, C18, C19, C20, C21, C22, C23, C24, C25, C26 | 19 | Capacitor | | 100nF | ETML_ES | ----------------- | ------- | ------- | ------- | ------- | ----------------- | ----------------- | | * | 0

22pF | ETML-ES | ----------------- | ------- | ------- | ------- | ------- | ----------------- | ----------------- | -- Capacitor

C7, C16, C17, C27 | 4 | Capacitor | 10uF | ETML-ES | ----------------- | ------- | ------- | ------- | ------- | ----------------- | ----------------- | - | * | 0

330nF | ETML-ES | ----------------- | ------- | ------- | ------- | ------- | ----------------- | ----------------- | -- Capacitor | * | 0

220pF | ETML-ES | ----------------- | ------- | ------- | ------- | ------- | ----------------- | ----------------- | -- Capacitor | * | 0

Yellow | ETML-ES | ----------------- | ------- | ------- | ------- | ------- | ----------------- | ----------------- | -- SMT Mono-color Chip LED | * | 0

LCD_NHD_0420AZ | Digi-Key | NHD-0420AZ-FSW-GBW-33V3-ND | 19.100 | 17.491 | 15.7723 | ------- | 1 | 15.7723 | -- Affichage LCD | * | 15.7723

691214110002S | MOUSER | 710-691214110002S | 1.110 | 11.000 | 93.400 | 781.000 | 1 | 93.400 | - Bornier 2 pôles - | * | 93.400

47346-0001 | MOUSER | 538-47346-0001 | 0.890 | 8.01 | 68.70 | 491.000 | 1 | 68.70 | - Micro-USB B - | * | 68.70

SI-60062-F | ETML-ES | ----------------- | ------- | ------- | ------- | ------- | ----------------- | ----------------- | - 1 Port RJ45 Magjack - | * | 0

Header 7 | ETML-ES | ----------------- | ------- | ------- | ------- | ------- | ----------------- | ----------------- | -- Header, 7-Pin | * | 0

BC857B | ETML-ES | ----------------- | ------- | ------- | ------- | ------- | ----------------- | ----------------- | -- PNP Silicon AF Transistor | * | 0

Q1, Q2 | 2
Q3, Q4 | 2 | IRLML2402TRPBF | ETML-ES | ----------------- | ------- | ------- | ------- | ------- | ----------------- | ----------------- | -- Power MOSFET, N-Channel | * | 0

39R | ETML-ES | ----------------- | ------- | ------- | ------- | ------- | ----------------- | ----------------- | - Resistor - | * | 0

10k | ETML-ES | ----------------- | ------- | ------- | ------- | ------- | ----------------- | ----------------- | - Resistor - | * | 0

1k8 | ETML-ES | ----------------- | ------- | ------- | ------- | ------- | ----------------- | ----------------- | - Resistor - | * | 0

200R | ETML-ES | ----------------- | ------- | ------- | ------- | ------- | ----------------- | ----------------- | - Resistor - | * | 0

100k | ETML-ES | ----------------- | ------- | ------- | ------- | ------- | ----------------- | ----------------- | - Resistor - | * | 0

4k7 | ETML-ES | ----------------- | ------- | ------- | ------- | ------- | ----------------- | ----------------- | - Resistor - | * | 0

470R | ETML-ES | ----------------- | ------- | ------- | ------- | ------- | ----------------- | ----------------- | - Resistor - | * | 0

3.3k | ETML-ES | ----------------- | ------- | ------- | ------- | ------- | ----------------- | ----------------- | - Resistor - | * | 0

1k | ETML-ES | ----------------- | ------- | ------- | ------- | ------- | ----------------- | ----------------- | - Resistor - | * | 0

ETML | Liste de Pièces 1819_A

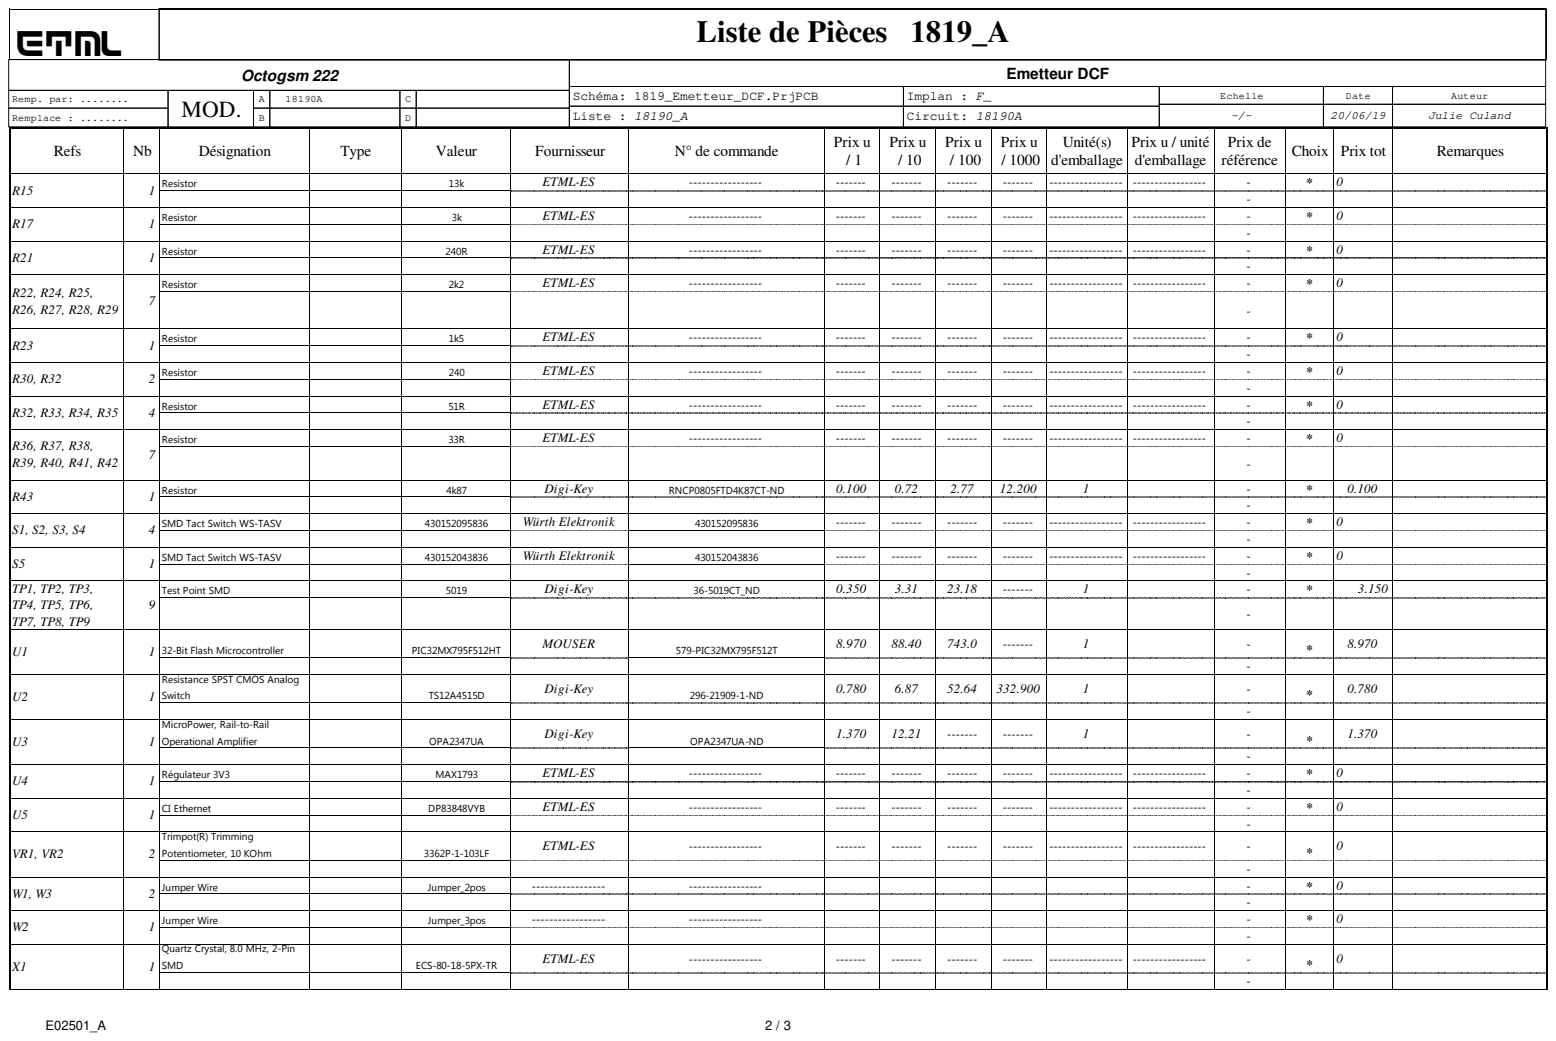
[picture p56: page 2]
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

R15 | 1 | Resistor | | 13k | ETML-ES | ----------------- | ------- | ------- | ------- | ------- | ----------------- | ----------------- | - | * | 0

3k | ETML-ES | ----------------- | ------- | ------- | ------- | ------- | ----------------- | ----------------- | - Resistor - | * | 0

240R | ETML-ES | ----------------- | ------- | ------- | ------- | ------- | ----------------- | ----------------- | - Resistor - | * | 0

2k2 | ETML-ES | ----------------- | ------- | ------- | ------- | ------- | ----------------- | ----------------- | - Resistor - | * | 0

1k5 | ETML-ES | ----------------- | ------- | ------- | ------- | ------- | ----------------- | ----------------- | - Resistor - | * | 0

240 | ETML-ES | ----------------- | ------- | ------- | ------- | ------- | ----------------- | ----------------- | - Resistor - | * | 0

51R | ETML-ES | ----------------- | ------- | ------- | ------- | ------- | ----------------- | ----------------- | - Resistor - | * | 0

33R | ETML-ES | ----------------- | ------- | ------- | ------- | ------- | ----------------- | ----------------- | - Resistor - | * | 0

4k87 | Digi-Key | RNCP0805FTD4K87CT-ND | 0.100 | 0.72 | 2.77 | 12.200 | 1 | | -- Resistor | * | 0.100

430152095836 | Würth Elektronik | 430152095836 | ------- | ------- | ------- | ------- | ----------------- | ----------------- | - SMD Tact Switch WS-TASV - | * | 0

430152043836 | Würth Elektronik | 430152043836 | ------- | ------- | ------- | ------- | ----------------- | ----------------- | - SMD Tact Switch WS-TASV - | * | 0

5019 | Digi-Key | 36-5019CT_ND | 0.350 | 3.31 | 23.18 | ------- | 1 | | - Test Point SMD - | * | 3.150

PIC32MX795F512HT | MOUSER | 579-PIC32MX795F512T | 8.970 | 88.40 | 743.0 | ------- | 1 | | - 32-Bit Flash Microcontroller -

- Resistance SPST CMOS Analog

U2 | 1 | Switch | TS12A4515D | Digi-Key | 296-21909-1-ND | 0.780 | 6.87 | 52.64 | 332.900 | 1 | - | * | 0.780

- MicroPower, Rail-to-Rail

U3 | 1 | Operational Amplifier | OPA2347UA | Digi-Key | OPA2347UA-ND | 1.370 | 12.21 | ------- | ------- | 1 | | - | * | 1.370

MAX1793 | ETML-ES | ----------------- | ------- | ------- | ------- | ------- | ----------------- | ----------------- | - Régulateur 3V3 - | * | 0

DP83848VYB | ETML-ES | ----------------- | ------- | ------- | ------- | ------- | ----------------- | ----------------- | - CI Ethernet - | * | 0

- Trimpot(R) Trimming

VR1, VR2 | 2 | Potentiometer, 10 KOhm | 3362P-1-103LF | ETML-ES | ----------------- | ------- | ------- | ------- | ------- | ----------------- | ----------------- | - | * | 0

Jumper_2pos | ----------------- | ----------------- | | | | | | | -- Jumper Wire | * | 0

Jumper_3pos | ----------------- | ----------------- | | | | | | | - Jumper Wire - | * | 0

- Quartz Crystal, 8.0 MHz, 2-Pin
SMD | ECS-80-18-5PX-TR | ETML-ES | ----------------- | ------- | ------- | ------- | ------- | ----------------- | ----------------- | - | * | 0

Refs | Nb | Désignation | Type | Valeur | Fournisseur | N° de commande | Prix u / 1 | Prix u / 10 | Prix u / 100 | Prix u / 1000 | Unité(s) d'emballage | Prix u / unité d'emballage | Prix de référence | Choix | Prix tot | Remarques
X2 | 1 | OSC, 50.000 MHZ, ± 25 ppm, 3.3 V, SMT | | 7W-50.000MBA-T | MOUSER | 887-1379-1-ND | 2.260 | 21.70 | 180.0 | ------- | 1 | | - | * | 2.260
| | | | | | | | | | | | | - Conrad - | * | 0
| | | | ----------------- | Digi-Key | HM3475-ND | 22.830 | 201.45 | 1813 | ------- | 1 | | - Boîtier plastique - | * | 22.830
ETML | Liste de Pièces 1819_A

Echelle

Liste : 18190_A | -/-

Schéma: 1819_Emetteur_DCF.PrjPCB

Circuit: 18190A

Implan : F_ | Date
| 20/06/19 Auteur
Remplace : ........ | Julie Culand
Remp. par: ........ | MOD.
A | 18190A
Octogsm 222 | Emetteur DCF

B

C

D

60x120x120 | - | Total: | 93.40
Antenne DCF | 2
Boîtier | 1
