ETML-ES-SLO/PRJ_1819_EmetteurDCF/1819A/hard/18191A_Partie analogique_SCA_Martins/hard/Project Outputs for 1819D_Emetteur_DCF/DesignDocs/Dimensional Drawings.PDF

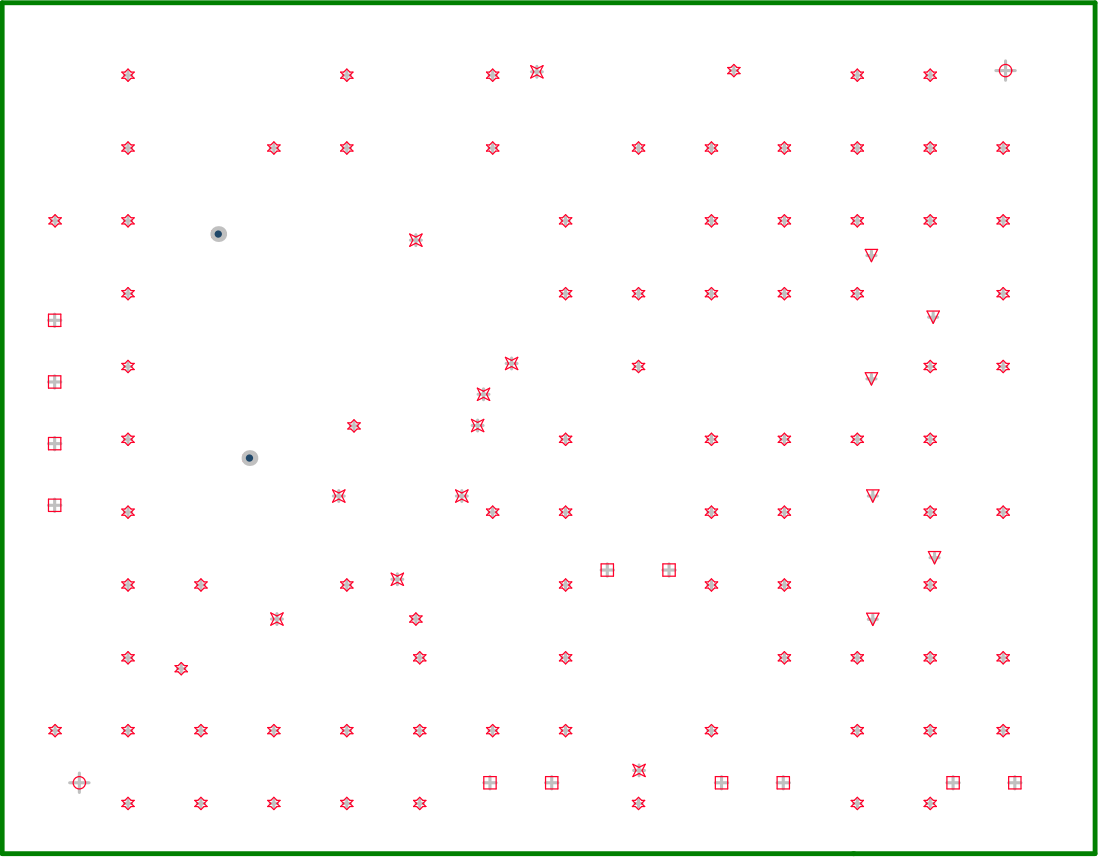
[picture p57: page 1]
