ETML-ES-SLO/PRJ_1819_EmetteurDCF/1819A/hard/18191A_Partie analogique_SCA_Martins/hard/Project Outputs for 1819D_Emetteur_DCF/DesignDocs/PCB Top-Bottom Assy Dwgs.PDF

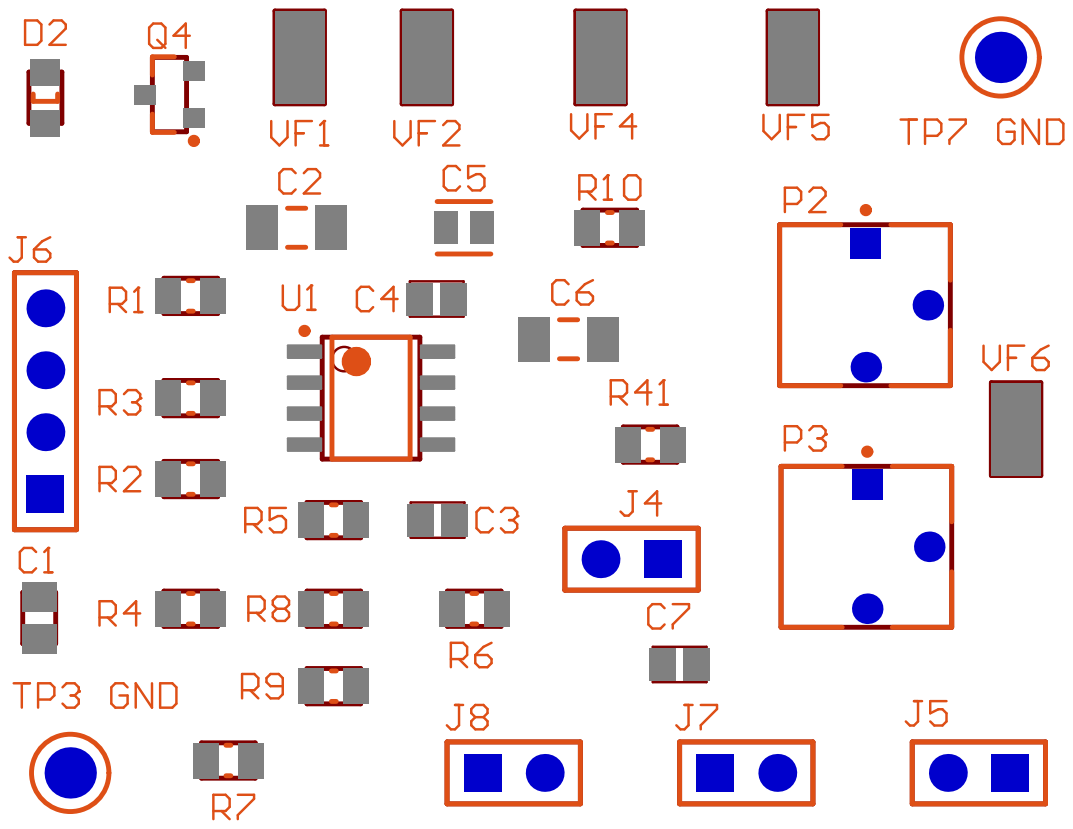
[picture p58: page 1]

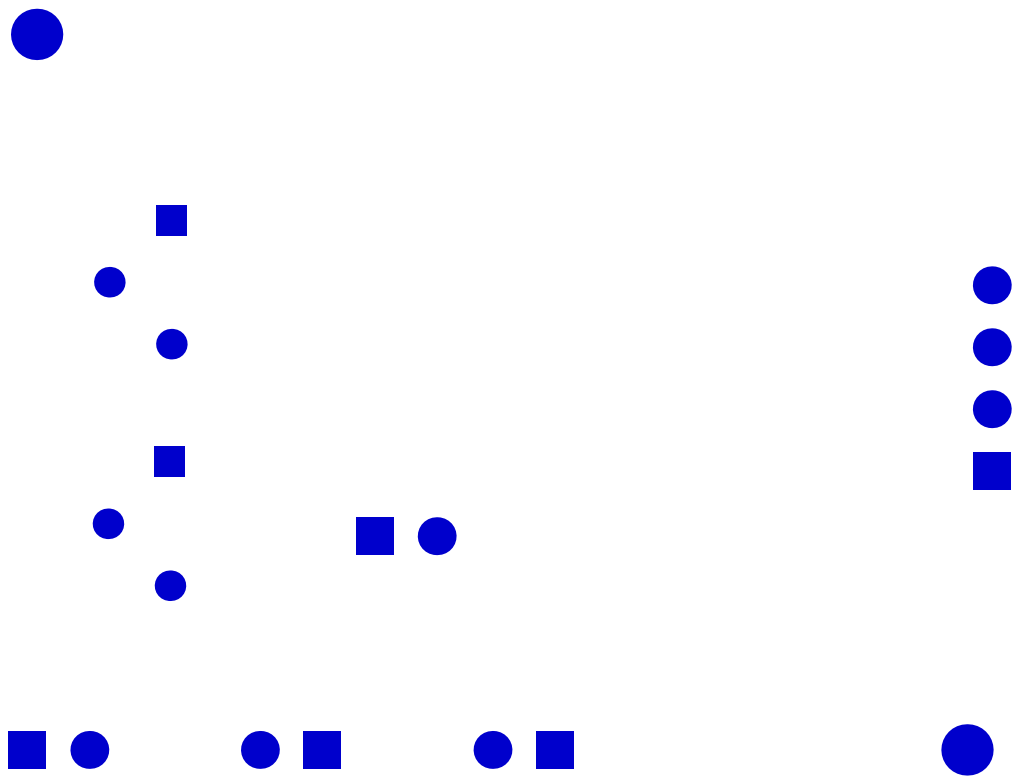
[picture p59: page 2]
