ETML-ES-SLO/PRJ_1819_EmetteurDCF/1819A/hard/18191A_Partie analogique_SCA_Martins/hard/Project Outputs for 1819D_Emetteur_DCF/DesignDocs/Schematic Prints.PDF

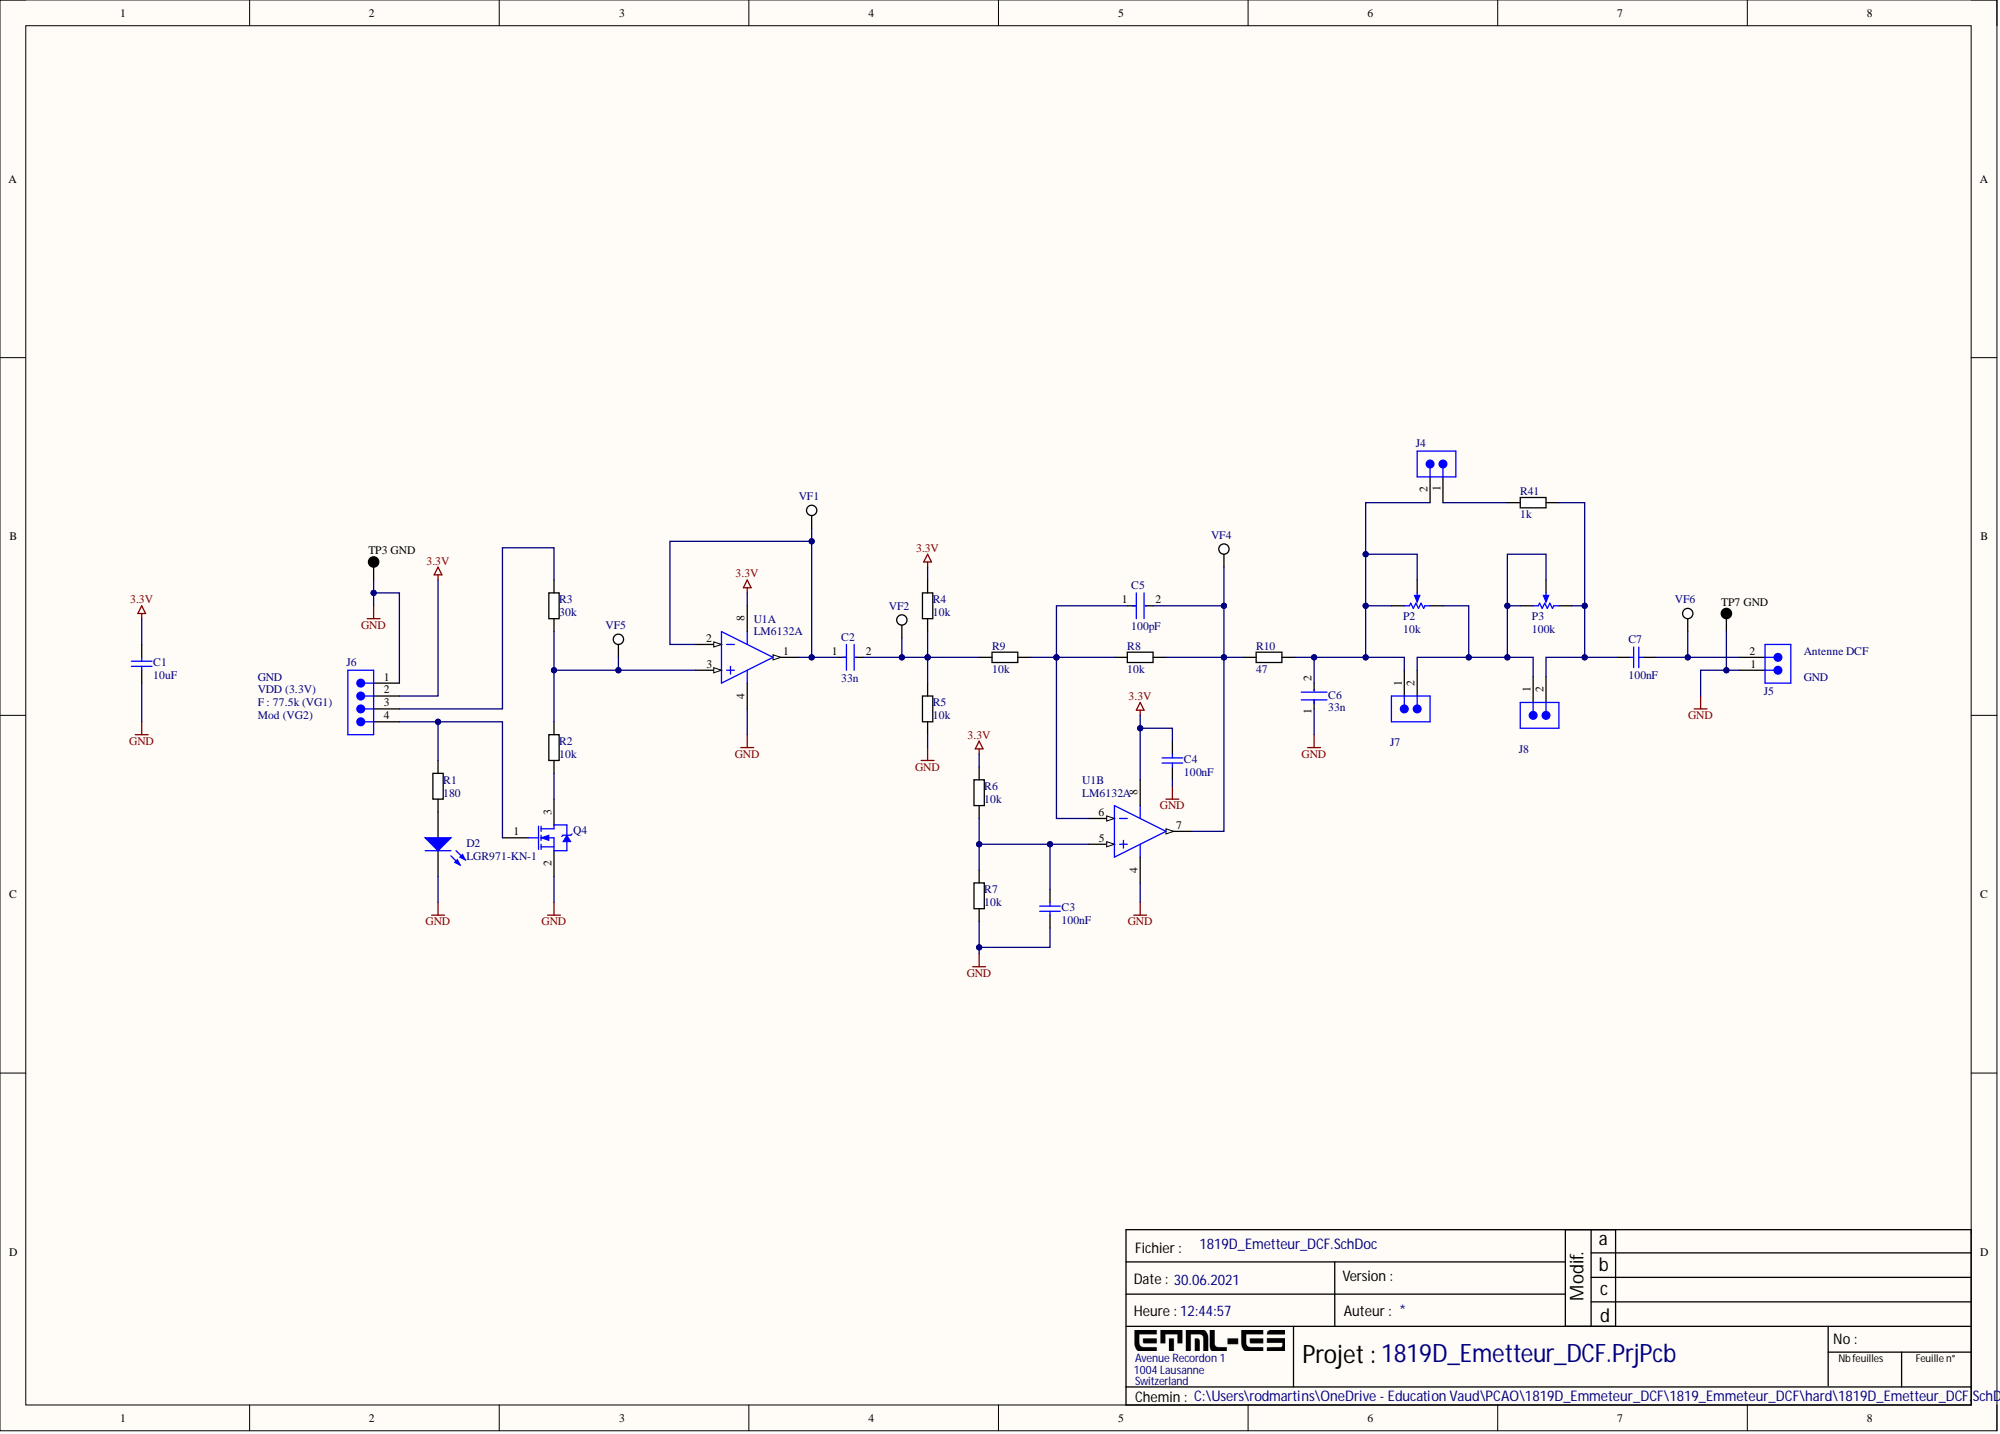
[picture p60: page 1]

1819D_Emet teur_DCF . S chDoc Fichier :

Date : 30.06.2021 | Version :

Heure : 12:44:57 | Auteur : *
Avenue R e cordon 1 1 00 4 Lausanne Switz e rland | Projet : 1819D_Emet teur_DCF.PrjPcb | No :

Nb feuille s | F euille n °

ion Vaud\PCAO\1819D_Emmeteur_DCF\1819_Emmeteur_DCF\hard\1819D_Emet
