ETML-ES-SLO/PRJ_1819_EmetteurDCF/1819A/doc/ANNEXES/Annexe_II_Schéma_électrique(part1).pdf

# Découplage PIC

# Affichage LCD

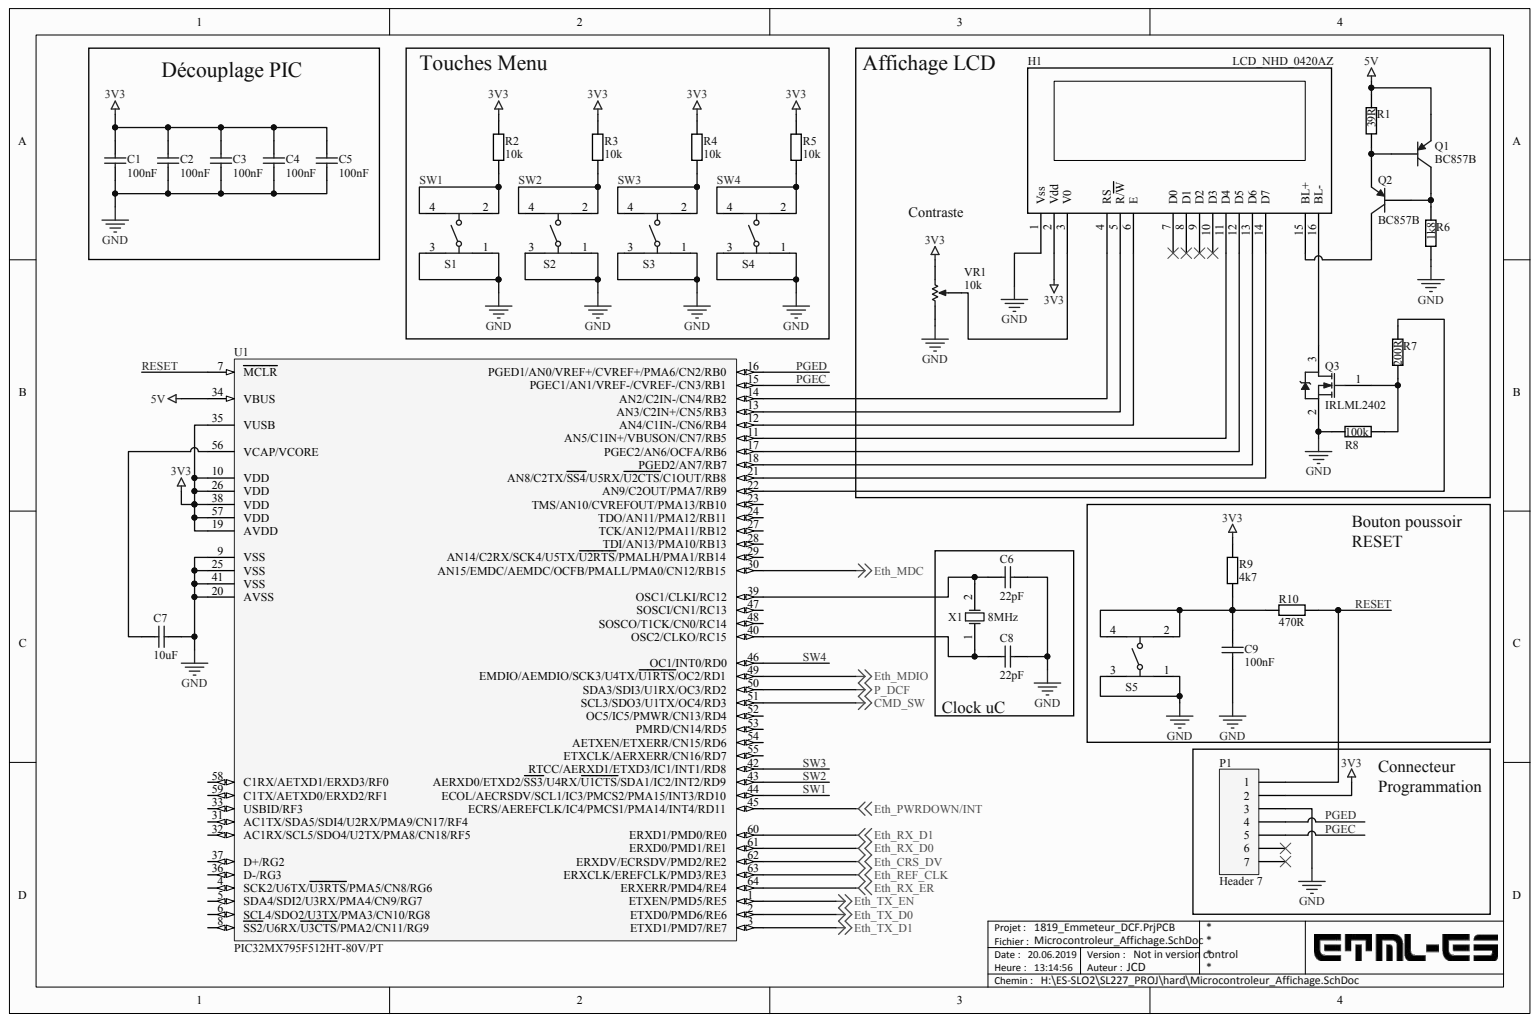
[picture p61: page 1]

Projet : 1819_Emmeteur_DCF.PrjPCB
Fichier :
Heure :
Chemin : H:\ES-SLO2\SL227_PROJ\hard\Microcontroleur_Affichage.SchDoc

Not in version control
JCD
