ETML-ES-SLO/PRJ_1819_EmetteurDCF/1819A/doc/ANNEXES/Annexe_II_Schéma_électrique(part2).pdf

# Signaux DCF

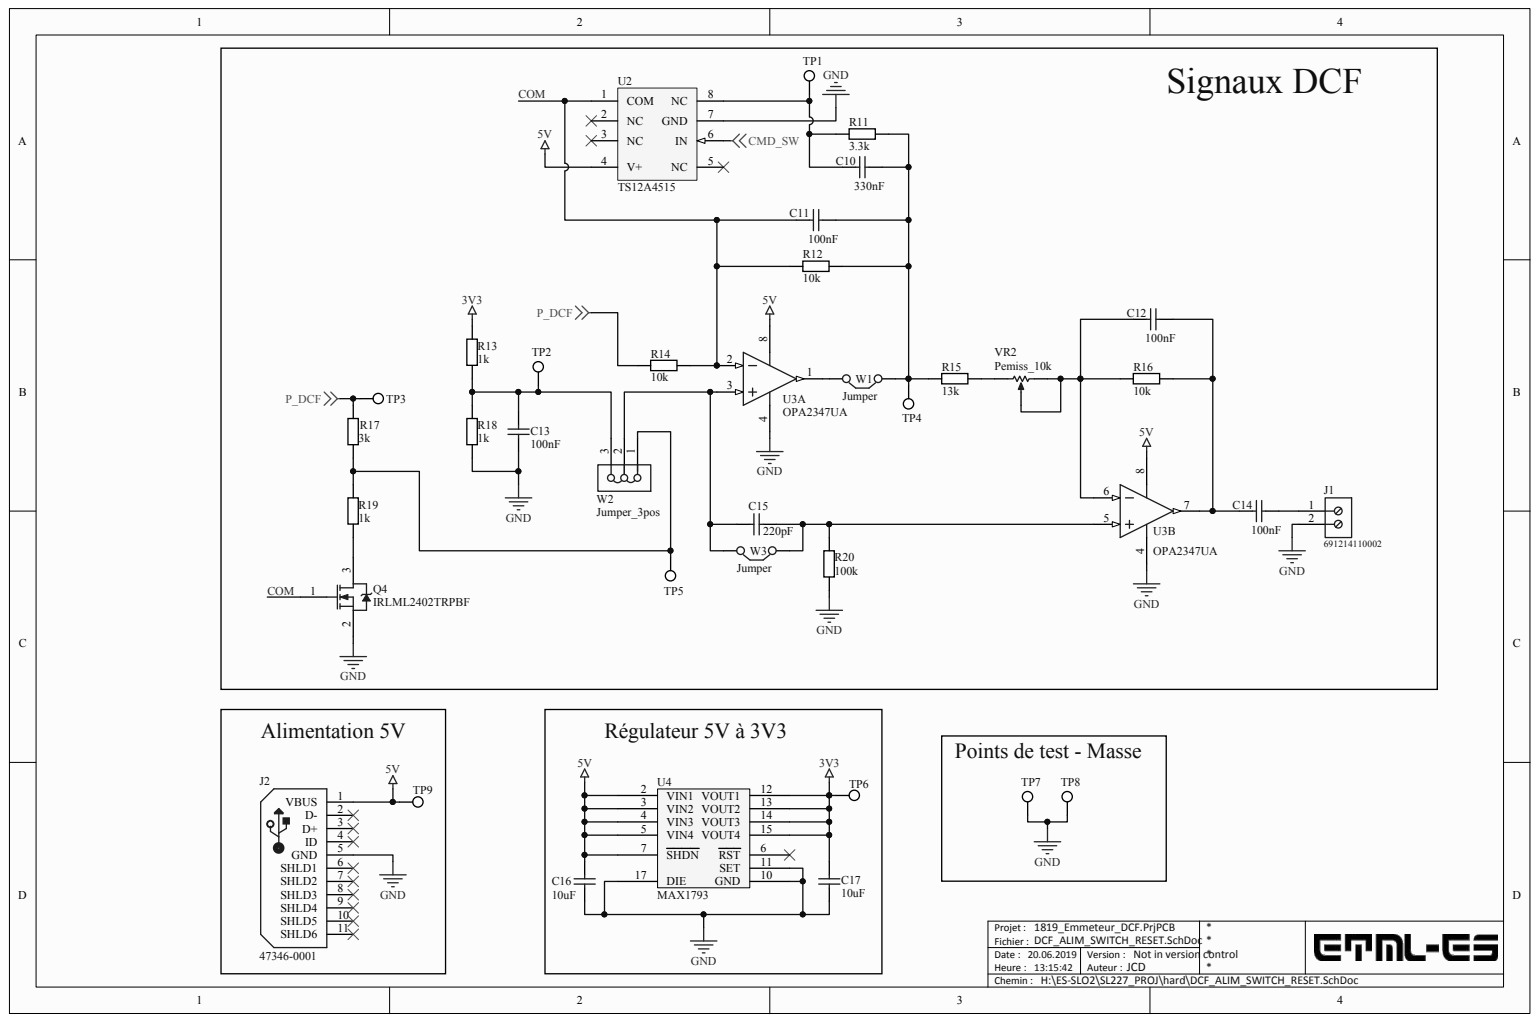
[picture p62: page 1]

Points de test - Masse

Projet : 1819_Emmeteur_DCF.PrjPCB
Fichier :
Heure :
Chemin : H:\ES-SLO2\SL227_PROJ\hard\DCF_ALIM_SWITCH_RESET.SchDoc

Not in version control
JCD
