ETML-ES-SLO/PRJ_1819_EmetteurDCF/1819A/doc/ANNEXES/Annexe_II_Schéma_électrique(part3).pdf

# Contrôleur Ethernet

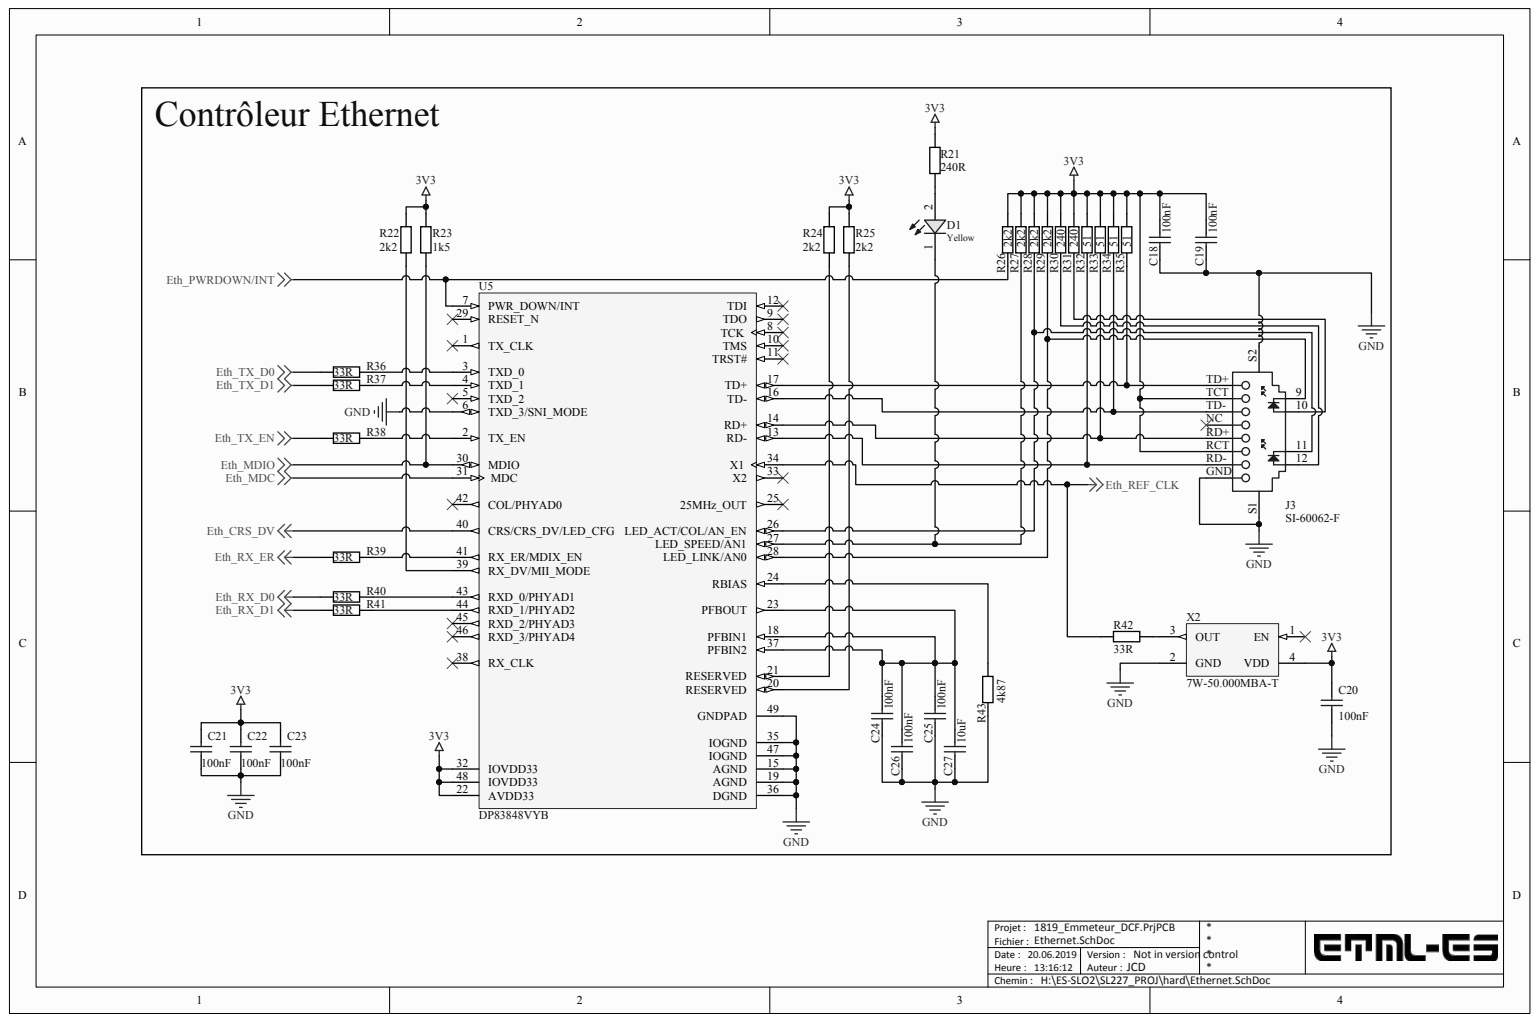
[picture p63: page 1]

Projet : 1819_Emmeteur_DCF.PrjPCB
Fichier :
Heure :
Chemin : H:\ES-SLO2\SL227_PROJ\hard\Ethernet.SchDoc

Not in version control
JCD
