ETML-ES-SLO/PRJ_1819_EmetteurDCF/(list of files, drawings)

Other design files:
1819A/hard/18190A_Culand/1819_Emmeteur_DCF.PcbDoc
1819A/hard/18190A_Culand/1819_Emmeteur_DCF.PrjPCB
1819A/hard/18190A_Culand/1819_Emmeteur_DCFb.PcbDoc
1819A/hard/18190A_Culand/DCF_ALIM_SWITCH_RESET.SchDoc
1819A/hard/18190A_Culand/Ethernet.SchDoc
1819A/hard/18190A_Culand/LibComposant1819.SchLib
1819A/hard/18190A_Culand/LibFootprint1819.PcbLib
1819A/hard/18190A_Culand/Microcontroleur_Affichage.SchDoc
1819A/hard/18190A_Culand/PCC-0018-00329-1/Released/VXH48A_N.PcbLib
1819A/hard/18190A_Culand/PCC-0137-00873-1/Released/MOLX-22-28-4033_V.PcbLib
1819A/hard/18190A_Culand/PCC-0151-00063-3/Released/TI-D8_L.PcbLib
1819A/hard/18190A_Culand/SYM-0018-00657-2/Released/IN-LNTX-DP83848VYB.SchLib
1819A/hard/18190A_Culand/SYM-0104-00873-1/Released/MOLX-22-28-4033.SchLib
1819A/hard/18190B_Culand/1819_Emmeteur_DCF.PcbDoc
1819A/hard/18190B_Culand/1819_Emmeteur_DCF.PrjPCB
1819A/hard/18190B_Culand/1819_Emmeteur_DCFb.PcbDoc
1819A/hard/18190B_Culand/DCF_ALIM_SWITCH_RESET.SchDoc
1819A/hard/18190B_Culand/Ethernet.SchDoc
1819A/hard/18190B_Culand/LibComposant1819.SchLib
1819A/hard/18190B_Culand/LibFootprint1819.PcbLib
1819A/hard/18190B_Culand/Microcontroleur_Affichage.SchDoc
1819A/hard/18190B_Culand/PCC-0018-00329-1/Released/VXH48A_N.PcbLib
1819A/hard/18190B_Culand/PCC-0137-00873-1/Released/MOLX-22-28-4033_V.PcbLib
1819A/hard/18190B_Culand/PCC-0151-00063-3/Released/TI-D8_L.PcbLib
1819A/hard/18190B_Culand/SYM-0018-00657-2/Released/IN-LNTX-DP83848VYB.SchLib
1819A/hard/18190B_Culand/SYM-0104-00873-1/Released/MOLX-22-28-4033.SchLib
1819A/hard/18191A_Partie analogique_SCA_Martins/hard/1819D_Emetteur_DCF.PcbDoc
1819A/hard/18191A_Partie analogique_SCA_Martins/hard/1819D_Emetteur_DCF.PrjPcb
1819A/hard/18191A_Partie analogique_SCA_Martins/hard/1819D_Emetteur_DCF.SchDoc
1819A/hard/18191A_Partie analogique_SCA_Martins/hard/Local_Lib.SchLib
1819A/hard/18191A_Partie analogique_SCA_Martins/hard/Local_PCBLib.PcbLib
